sagnikvolt/solar-pv-plant-5mwp-wb/linkedin/README.md

# LinkedIn and CV text (drafts)

Edit into your own voice. Post only after the repo is public (about 30 Nov). Do not claim anything marked "to verify".

## 1. Projects entry

**Title:** 5 MWp Ground-Mount Solar PV Plant: Design and Energy Yield Assessment (West Bengal)
**Dates:** Oct 2026 to Nov 2026
**Associated with:** IEM Kolkata
**Skills to tag:** PVsyst, Solar PV system design, Energy yield assessment, Python, NREL SAM, Cable sizing (add AutoCAD only if you do further work in it)

**Description:**
Designed a 5 MWp fixed-tilt, bifacial ground-mount solar plant using Kolkata's climate data, the way an EPC design team would prepare a preliminary package.
- Selected 565 Wp N-type TOPCon bifacial modules and 250 kW string inverters; sized strings against record temperatures (26 modules per string, 340 strings, DC/AC 1.25) with a Python tool and Excel version.
- Simulated in PVsyst with a 3D shading scene and a row-pitch sweep (6.4 to 9.0 m): 7,078 MWh/yr, 1,417 kWh/kWp, PR 85.6%; P90 6,458 MWh/yr from an assumed uncertainty budget.
- Cross-checked against NREL SAM and PVGIS; the 4.6% gap came from the irradiance database, and fell to 0.9% after scaling to the same irradiance.
- Sized DC and AC cables, transformers and the 33 kV connection concept; produced a plant layout and single-line diagram (generated in Python, saved as DWG in AutoCAD); estimated about 5,000 t CO2 avoided per year.
- Everything is documented with an assumption log. Preliminary design: no site survey, indicative costs.

**Link:** github.com/sagnikvolt/solar-pv-plant-5mwp-wb (add once public)

## 2. Post draft

> I spent the last few weeks designing a 5 MWp solar plant from scratch, to learn what an EPC design team actually does.
>
> The setup: 8,840 bifacial modules, 16 string inverters, Kolkata's climate, fixed tilt 20°.
>
> Three things I learned:
> 1. Row spacing is a trade-off, not a number. Going from 6.4 m to 9.0 m pitch added about 2.6% energy but needed 39% more land. I picked 8.0 m.
> 2. Different weather databases disagree. Kolkata's yearly irradiation is 1,574 (Meteonorm), 1,669 (NASA POWER) or 1,730 (PVGIS) kWh/m². PVsyst came out 4.6% below my SAM check until I scaled SAM to the same irradiance; then they were within 1%. The model was fine; the data source wasn't.
> 3. String sizing is set by the coldest morning. At 3.4 °C, 27 modules of my first module choice reached 1,497 V, just 3 V under the 1,500 V limit. With the final module 27 would still be only 20 V under, so I used 26 for a 5% margin.
>
> Result: 7,078 MWh/yr, PR 85.6%, P90 6,458 MWh/yr (assuming a 6.8% uncertainty). Layout and single-line diagram are in the repo (schematic for now).
>
> Everything, including every assumption and where I'm unsure, is in the repo: [link]
>
> I'm looking for graduate engineer roles in solar (design, projects or O&M) in West Bengal. Feedback from anyone who does this for real is very welcome.
>
> #solar #pvsyst #renewableenergy #westbengal

Numbers behind the post: pitch sweep `calcs/output/pitch_sweep.md` (energy 6,938 to 7,121 MWh = +2.6%; footprint 3.20 to 4.45 ha = +39%). Image to attach: `showcase/images/row_pitch_tradeoff.png` or the loss diagram.

## 3. CV bullets

- Designed and simulated a 5 MWp bifacial solar plant (8,840 modules, 16 string inverters) in PVsyst with 3D shading; achieved 7,078 MWh/yr at PR 85.6% and cross-checked against NREL SAM and PVGIS (gap explained to +0.9%).
- Sized strings, DC/AC cables, transformers and 33 kV evacuation to IEC practice, built a Python/Excel string-sizing tool, produced a schematic layout and single-line diagram, and documented every assumption in a public GitHub repository.

## 4. Things to verify before posting
- Module ALMM/DCR status (MNRE site).
- Capex and LCOE are left out of the post on purpose: they are indicative ranges, not quotes.
- The repo is private until about 30 Nov; add the link only when public.
