sagnikvolt/solar-pv-plant-5mwp-wb/ASSUMPTIONS.md

# Assumptions Log

Every design input that isn't a direct measurement goes here. Each row needs a **source** and a **reason**. When a value changes, update it and note the change in the last column.

| # | Area | Assumption | Value | Source | Reason / note | Changed? |
|---|---|---|---|---|---|---|
| 1 | Plant | DC capacity | 5.0 MWp (design: 4,994.6 kWp) | Project scope | Typical single-feeder 33 kV ground-mount size; actual capacity is set by whole strings | |
| 2 | Plant | Target DC/AC ratio | 1.25 (actual 1.249) | Industry practice | Balance clipping vs. inverter cost; to be tested in PVsyst | |
| 3 | Site | Location | Kolkata, 22.57 °N, 88.36 °E, 15 m | Project choice | Resource site; exact plot TBD (see `data/site.md`) | 28 Oct: changed from Bankura to Kolkata |
| 4 | Site | Record minimum ambient | 3.4 °C | NASA POWER daily T2M_MIN, 2001–2025 | Sets maximum string Voc. Gridded value; a station may read slightly lower | |
| 5 | Site | Design maximum ambient | 47 °C | NASA POWER daily T2M_MAX (46.9 °C) rounded up | Sets minimum string Vmp (MPPT window) | |
| 6 | Irradiance | Annual GHI | Meteonorm 8.1 (1991–2012): **1,573.6**; NASA POWER: 1,669 (+6.1%); PVGIS-ERA5 (2005–2020): 1,730 (+10.0%) kWh/m² | PVsyst Meteonorm import; NASA POWER; PVGIS v5.3 | Spread far above the 3% threshold. Meteonorm is the lowest and the most conservative; it is the basis of the PVsyst simulation. Causes to investigate for the report: different averaging periods, satellite vs. interpolated ground data, and aerosol treatment. Year-to-year GHI variability (Meteonorm): 3.2% | |
| 7 | Module | Model and class | Waaree ELITE BiN-08-565 (565 W) | Waaree datasheet WEL/E&PD/565-600/144/BiN-08/HC/09/03.01.2025 (see `data/datasheets/SOURCES.md`) | N-type TOPCon, bifacial, 144 half-cut cells. **ALMM List-I and DCR status not yet verified** | 28 Oct: 580 W class rejected, see #14 |
| 8 | Module | STC values | Voc 51.9 V, Vmp 43.56 V, Isc 13.75 A, Imp 12.97 A | Same datasheet | | |
| 9 | Module | Temperature coefficients | β(Voc) −0.26 %/°C, α(Isc) +0.046 %/°C, γ(Pmax) −0.30 %/°C; NOCT 43 °C | Same datasheet | The datasheet gives no β(Vmp) | |
| 10 | Inverter | Model | Sungrow SG250HX | Sungrow datasheet v1.22 (© 2019; see SOURCES.md) | 1500 V string inverter, 12 MPPTs, 250 kVA at 30 °C. **Derates to 225 kVA at 40 °C and 200 kVA at 50 °C**: PVsyst must model this for Kolkata summers | |
| 11 | Inverter | Limits used | Vdc max 1500 V; MPPT 600–1500 V; 2 string inputs per MPPT; 26 A operating and 50 A Isc per MPPT | Same datasheet | Newer datasheet revisions may state a lower MPPT minimum voltage; 600 V is conservative | |
| 12 | Design | Cell temperature model | Tcell = Tamb + (NOCT − 20)/800 × 1000 | IEC 61215 NOCT convention | Used for hot-condition Vmp and Isc (75.8 °C) | |
| 13 | Design | Vmp temperature coefficient | γ(Pmax) = −0.30 %/°C used as β(Vmp) | Common approximation | PVsyst's model derives −0.33 %/°C, so −0.30 slightly overstates hot Vmp. No effect on the design: the minimum string is 17 modules and 26 are used | |
| 14 | Design | String length | 26 modules (maximum allowed is 27) | `calcs/output/` | At 27 with the final 565 W module, string Voc reaches 1,480 V (20 V below the limit), so one module was dropped for a 5% margin (1,425 V). The first-pass 580 W module reached 1,497 V at 27. See `iteration1_580W_27mod_FAILED.md` | Iteration 2 |
| 15 | Design | Module class | 565 W instead of 580 W | `calcs/output/` | With the 580 W class, two strings on one MPPT draw 26.36 A, above the inverter's 26 A limit. The 565 W class gives 25.94 A | Iteration 2 |
| 16 | Design | Bifacial rear gain (current only) | 10% | Engineering assumption | Conservative input for current checks only; PVsyst computes the real gain | |
| 17 | Site | Ground albedo (bifacial) | 0.25 | Engineering assumption (grass or bare soil, range 0.2 to 0.3) | PVsyst default is 0.30. Set lower to be conservative. The site file itself carries 0.20 for the front-side model | 28 Oct: set |
| 18 | Losses | Soiling | 3.0% flat annual | Common Indian utility assumption; no site measurement | Monsoon rain cleans in Jun to Sep and winter is dusty, so monthly values would be better. To refine | 28 Oct: set |
| 19 | PVsyst | Weather file | Kolkata_MN81_SYN.MET (Meteonorm 8.1, synthetic hourly) | PVsyst, 28 Oct 2026 | Coordinates picked from PVsyst's map: 22.563 °N, 88.363 °E, 11 m, UTC+5.5 | |
| 20 | PVsyst | Orientation | Fixed tilt 20°, azimuth 0° (south) | PVsyst quick optimisation | Transposition factor 1.06; 0.1% below the optimum (30° would be 0.6% below). Lower tilt also shortens row pitch | |
| 21 | PVsyst | Module file | Waaree_Energies_BiN-08-565.PAN, created by hand from the datasheet | Datasheet values (see #7–9) | Not in PVsyst's Waaree list (older WSMD models only). Created from the WSMD-545 template; Pmax temp. coefficient set to −0.30 %/°C and bifaciality 0.80. PVsyst's one-diode model derives Voc −0.25 %/°C and Vmp −0.33 %/°C (my hand calc used −0.30 for Vmp, so PVsyst is slightly more conservative on Vmp). Rsh/Rs are PVsyst defaults, not from the datasheet | |
| 22 | PVsyst | Inverter | Sungrow SG250-HX from PVsyst's database | PVsyst database (since 2022) | The database entry lists the MPPT range as 500–1450 V; datasheet v1.22 says 600–1500 V. Both are satisfied by the 26-module string (Vmp 960–1206 V) | |
| 23 | PVsyst | Array | 26 modules in series, 340 strings, 16 inverters (192 MPPT inputs) | `calcs/string_sizing.py` | PVsyst confirms 8,840 modules, 4,995 kWp, 4,000 kWac, ratio 1.249, Voc at −10 °C 1,465 V. 44 MPPT inputs get 1 string and 148 get 2 | |
| 24 | PVsyst | Row pitch | **8.0 m** (GCR 58%) | `calcs/row_pitch.py`, `calcs/pitch_sweep.py` | 6.4 m is the minimum for no shading 9:00 to 15:00 on 21 Dec at Kolkata. PVsyst sweep: 6.4 m 6,938; 7.0 m 7,006; 8.0 m 7,078; 9.0 m 7,121 MWh. Gains flatten above 8 m while land keeps growing. May change with the real plot and land cost | 28 Oct: 7.0 to 8.0 m |
| 25 | PVsyst | Table geometry | 2 modules portrait, 4.58 m deep, 20° tilt, 1.0 m lower-edge height, 17 rows of 260 modules in length (300 m) | Engineering assumption | 1.0 m clearance for flood-prone West Bengal. Row length is a placeholder until the real plot is chosen | 28 Oct |
| 26 | PVsyst | Bifacial model | Unlimited sheds 2D; bifaciality 80%; rear shading 5%; rear mismatch 10% | PVsyst defaults and module file | PVsyst gives 6.5% rear irradiance relative to front. Estimated net energy gain about 4.7% (6.5% × 0.80 × 0.90, my arithmetic, not a PVsyst output) | 28 Oct |
| 27 | PVsyst | Near shading | Linear shadings (fast table) from the 3D scene, 2.26% loss at 7.0 m pitch (VC1); 1.75% at the adopted 8.0 m (VC4) | PVsyst | Conservative vs electrical (module-string) shading. Module-layout partition not defined yet | 28 Oct |
| 28 | PVsyst | Thermal model | Free-standing: Uc 29 W/m²K, Uv 0 | PVsyst convention for free-mounted | Cuts temperature loss from 7.8% (Uc 20) to 5.6%, a gain of about 2%. Worth cross-checking against SAM | 28 Oct |
| 29 | PVsyst | Other losses | LID 0.5%; module quality 0.0% (PVsyst default assumes a 0.5% gain, removed); mismatch 2.0%; DC ohmic 1.5% at STC (to confirm by cable sizing); unavailability 1.0%; AC wiring and auxiliaries not modelled | Engineering assumptions | Availability is placed in 3 random periods totalling 3.7 days, which distorts the monthly chart (June PR 0.776). Annual total unaffected | 28 Oct |
| 30 | Uncertainty | P50/P90 budget | σ(1 yr) 6.84%: data source 5.0, interannual 3.2, transposition 2.0, PV model 2.0, module 1.5, soiling 1.0, availability 0.5 | `calcs/p50_p90.py` | All components are assumptions. On the VC4 P50 of 7,078 MWh: P90 (1 yr) 6,458 MWh | 28 Oct |
| 31 | Check | Bifacial gain | +4.4% (monofacial VC2 6,712 vs bifacial VC1 7,006 MWh, both at 7.0 m) | PVsyst runs | Replaces my earlier 4.7% estimate | 28 Oct |
| 32 | Check | SAM / PVGIS cross-check | PVsyst monofacial sits 4.6% and 6.6% below SAM and PVGIS (ERA5) after removing shading; within 0.9% after scaling SAM to Meteonorm GHI | `calcs/crosscheck_sam_pvgis.md` | Difference is irradiance database, not model. SAM and PVGIS share ERA5, so this does not validate the irradiance choice | 28 Oct |
| 33 | Cables | DC string cable | Copper H1Z2Z2-K 1.5 kV; design current 1.25 x Isc x 1.10 = 18.9 A; temperature derating 0.91 (70 C ambient, 120 C cable); grouping 0.80; voltage drop limit 1.0% at Imp | IEC 62548-style practice; `calcs/cable_sizing.py` | Result: 4 mm2 to about 70 m, 6 mm2 to 100 m, 10 mm2 to 130 m. Row lengths and combiner positions are not drawn yet, so cable lengths are placeholders | 28 Oct |
| 34 | Cables | Inverter to transformer cable | Aluminium XLPE, 80 m, 240 mm2, 3 single-core per inverter; buried derating 0.80; drop at most 0.5% at rated 180.5 A | `calcs/cable_sizing.py` | 185 mm2 gives 0.62%, so 240 mm2 chosen. Ampacities are typical datasheet values, not verified against a specific vendor | 28 Oct |
| 35 | Electrical | Transformers | 2 x 2.5 MVA, 0.8/33 kV Dyn11 ONAN; 8 inverters each; no-load 2.1 kW, load loss 20 kW | Engineering assumption, typical values | Check against vendor data. Inverters derate to 225 kVA at 40 C, so 2.5 MVA is not overloaded | 28 Oct |
| 36 | Electrical | 33 kV evacuation | 70 A at 4.0 MW; 3 km ACSR Dog overhead line (R 0.27 ohm/km); drop 0.30%, loss 11.9 kW | Placeholder | Line length and grid substation are unknown until the plot and DISCOM feasibility are fixed | 28 Oct |
| 37 | Losses | AC-side energy loss | 161.3 MWh/yr (2.28% of 7,078); load-form factor mean(P^2)/Prated^2 = 0.20 | `calcs/cable_sizing.py` | The 0.20 factor is an assumption; replace with PVsyst hourly output. Net 6,917 MWh/yr at the 33 kV point | 28 Oct |
| 38 | Economics | Capex | Cost lines positioned at the 25th percentile of published indicative ranges: INR 4.42 crore/MWp (22.1 crore); low case 3.54, high 7.08 per MWp | taypro.in cost guide (updated 21 Jun 2026); `calcs/economics.py` | Commercial blog, not a regulator figure. Even the low case gives LCOE above auction tariffs, so quote only as a range until a CERC/SERC benchmark or EPC quote is found | 28 Oct |
| 39 | Economics | Financial inputs | Discount rate 10% nominal pre-tax; O&M INR 5 lakh/MWp/yr escalating 4%; insurance 0.3% of EPC; inverter replacement INR 0.48 crore in year 12; degradation 0.4%/yr; 25 years; no tax, debt or subsidy | Engineering/finance assumptions | None is sourced to a project; they are typical placeholders | 28 Oct |
| 40 | Economics | Tariff scenarios | INR 2.34 (GUVNL auction, Mar 2026), 3.00 (base, my assumption), 3.62 (DVC West Bengal interim, Mar 2025) | News headlines | Headlines only, full orders not opened | 28 Oct |
| 41 | Environment | Grid emission factor | 0.727 tCO2/MWh (weighted average), 0.757 (combined margin) | CEA CO2 Baseline Database v20.0, FY 2023-24 | About 5,030 to 5,240 t/yr avoided in year 1. A falling grid factor makes later years lower | 28 Oct |
| 42 | Drawings | Layout geometry | 17 rows x 10 tables (30.0 m each); 4.30 m plan depth per table; 4 m internal road 6 m outside the array; fence 12 m beyond the array; inverters shown at the east end of rows 1 to 16; yard 56 m x 116 m east of the array; fence area about 6.2 ha (15 acres) | Engineering assumption, `calcs/make_drawings.py` | Schematic. Symbols are enlarged, yard position and 33 kV route are placeholders, and the real plot may need a different shape. The 3.97 ha figure elsewhere is the array footprint only | 28 Oct |
