sagnikvolt/solar-pv-plant-5mwp-wb/calcs/output/weather_comparison.md

# Irradiance cross-check

| Source | Annual GHI (kWh/m²/yr) | Δ vs Meteonorm |
|---|---|---|
| Meteonorm | 1,574 | +0.0% |
| PVGIS | 1,730 | +10.0% |
| NASA POWER | 1,669 | +6.1% |

_Explain any difference above ~3% in the report (data period, satellite vs. ground-station interpolation, spatial resolution)._
