sagnikvolt/solar-pv-plant-5mwp-wb/showcase/pvsyst_report_VC4_pitch8m_PRELIMINARY.pdf

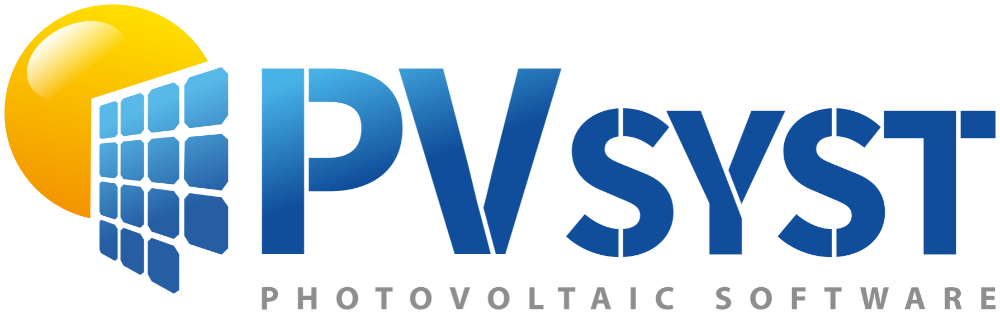
[picture p20: figure]

## Version 7.4.7

# PVsyst - Simulation report

# Grid-Connected System

# Project: SPV5_Kolkata_5MWp

## Variant: Bifacial 20deg, PITCH 8.0m, 3D sheds, soiling 3pct Sheds, single array System power: 4995 kWp Kolkata - India

Author

PVsyst V7.4.7
VC4, Simulation date:
28/10/26 13:35
with V7.4.7

## Project: SPV5_Kolkata_5MWp

### Variant: Bifacial 20deg, PITCH 8.0m, 3D sheds, soiling 3pct

PVsyst Licensed to

### Project summary

Geographical Site
Kolkata
India

Situation
Latitude
Longitude
Altitude
Time zone

22.56
88.36
11
UTC+5.5

°N
°E
m

Project settings
Albedo | 0.20

Weather data
Kolkata
Meteonorm 8.1 (1991-2012) - Synthetic

### System summary

Grid-Connected System | Sheds, single array

PV Field Orientation
Fixed plane
Tilt/Azimuth | 20 / 0 °

Near Shadings
Linear shadings : Fast (table)

User's needs
Unlimited load (grid)

System information
PV Array
Nb. of modules
Pnom total

8840
4995

units
kWp

Inverters
Nb. of units
Pnom total
Pnom ratio

16
3999
1.249

units
kWac

### Results summary

Produced Energy | 7078053 kWh/year | Specific production | 1417 kWh/kWp/year Perf. Ratio PR | 85.65 %

### Table of contents

Project and results summary
General parameters, PV Array Characteristics, System losses Near shading definition - Iso-shadings diagram
Main results
Loss diagram
Predef. graphs

2
3
5
6
7
8

PVsyst V7.4.7
VC4, Simulation date:
28/10/26 13:35
with V7.4.7

### General parameters

Grid-Connected System | Sheds, single array

PV Field Orientation
Orientation
Fixed plane
Tilt/Azimuth | 20 / 0 °

Sheds configuration
Nb. of sheds
Single array

17 units

Sizes
Sheds spacing
Collector width
Ground Cov. Ratio (GCR)
Top inactive band
Bottom inactive band

8.00
4.58
57.2
0.02
0.02

m
m
%
m
m
Shading limit angle
Limit profile angle | 23.1 °

Models used
Transposition
Diffuse
Circumsolar

Perez
Perez, Meteonorm
separate

Horizon
Free Horizon

Near Shadings
Linear shadings : Fast (table)

User's needs
Unlimited load (grid)

Bifacial system
Model | 2D Calculation
| unlimited sheds
Bifacial model geometry
Sheds spacing Sheds width Limit profile angle GCR Height above ground | 8.00
| 4.62
| 23.1
| 57.7
| 1.00 m
| m
| °
| %
| m

Bifacial model definitions Ground albedo
Bifaciality factor
Rear shading factor
Rear mismatch loss
Shed transparent fraction

0.25
80
5.0
10.0
0.0

%
%
%
%

### PV Array Characteristics

PV module
Manufacturer Model | Waaree Energies
| BiN-08-565
(Custom parameters definition)
Unit Nom. Power | 565 Wp
Number of PV modules Nominal (STC) Modules | 8840
| 4995
| 340 string x 26 units
| kWp
| In series
At operating cond. (50°C)
Pmpp U mpp I mpp | 4620
| 1034
| 4467 kWp
| V
| A

Inverter
Manufacturer
Model

Sungrow
SG250-HX
(Original PVsyst database)
Unit Nom. Power | 250 kWac
Number of inverters Total power | 192 * MPPT 8% 16
| 3999 units
| kWac
Operating voltage Pnom ratio (DC:AC) No power sharing between MPPTs | 500-1450
| 1.25 V

Total PV power
Nominal (STC)
Total
Module area

4995
8840
22836

kWp
modules
m²

Total inverter power
Total power
Number of inverters
Pnom ratio

3999
16
1.25

kWac
units

PVsyst V7.4.7

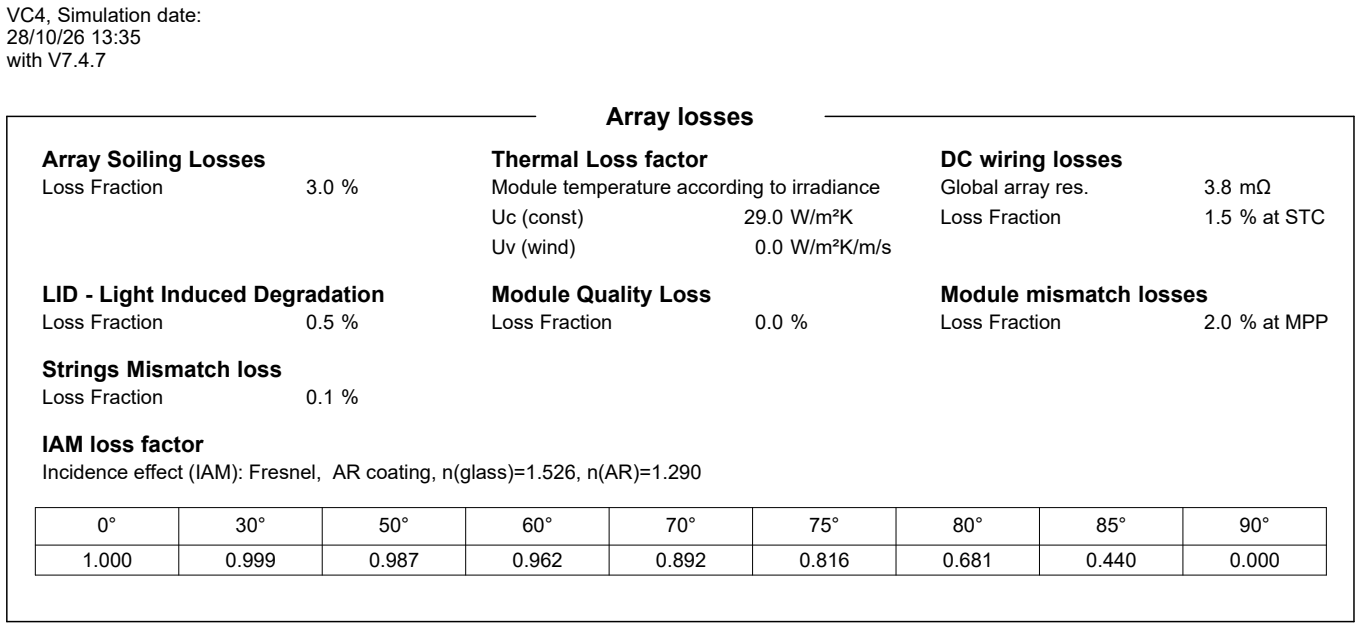
[picture p21: figure]
VC4, Simulation date: 28/10/26 13:35 with V7.4.7; Array losses; Array Soiling Losses; Loss Fraction; Thermal Loss factor; Module temperature according to irradiance; Uc (const); Uv (wind); W/m²K; W/m²K/m/s; DC wiring losses; Global array res.; % at STC; LID - Light Induced Degradation; Module Quality Loss; Module mismatch losses; 2.0 % at MPP; Strings Mismatch loss; IAM loss factor

Incidence effect (IAM): Fresnel, AR coating, n(glass)=1.526, n(AR)=1.290

### System losses

Unavailability of the system
Time fraction | 1.0
| 3.7
| 3

%
days,
periods

### Near shadings parameter

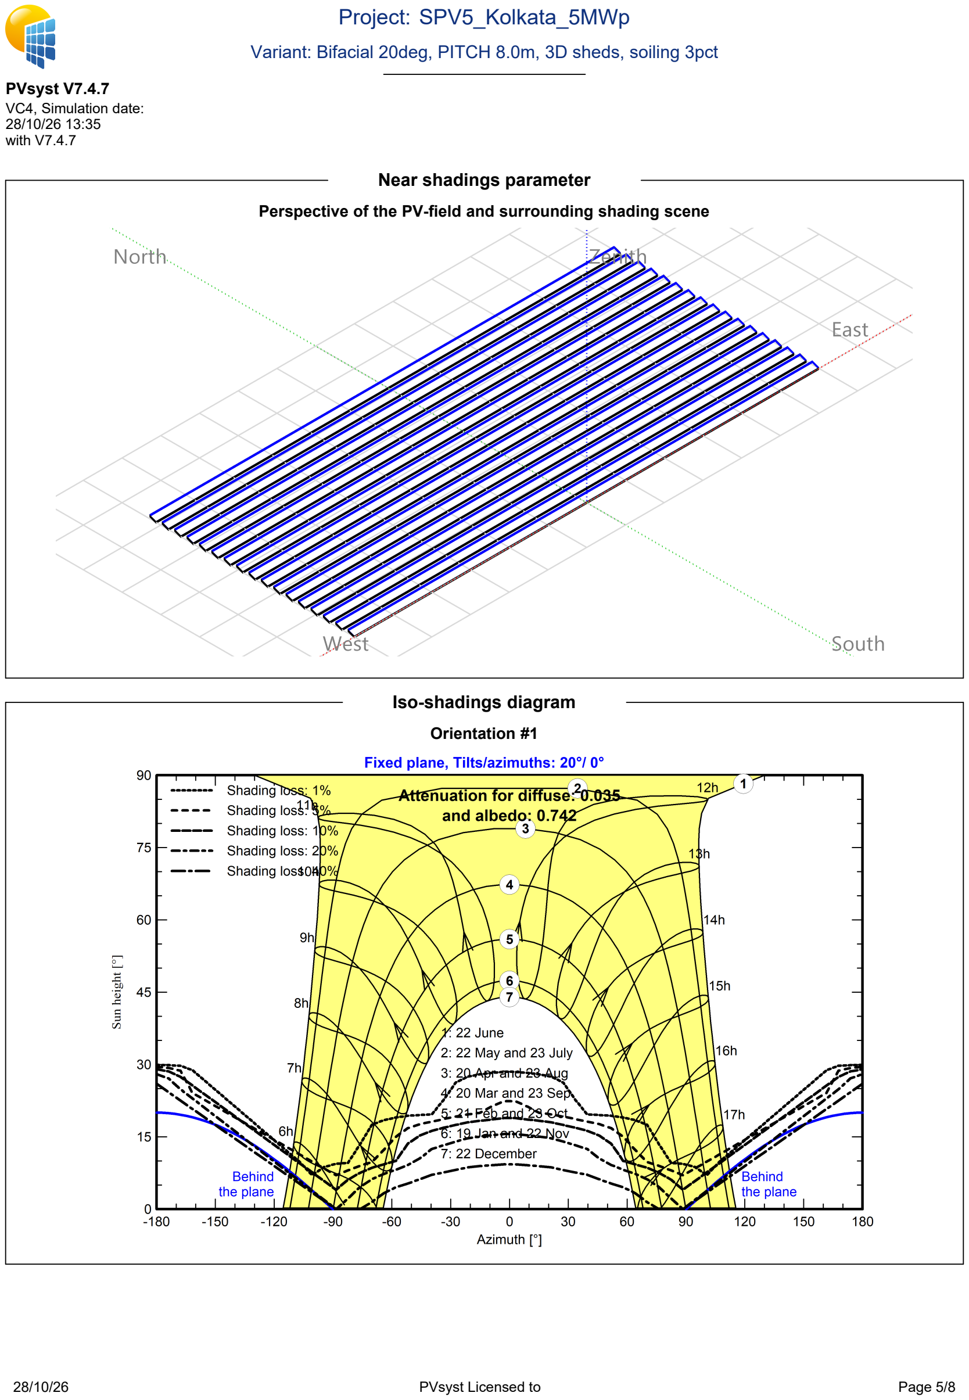
[picture p22: page 5]

PVsyst V7.4.7
VC4, Simulation date:
28/10/26 13:35
with V7.4.7

Perspective of the PV-field and surrounding shading scene

### Iso-shadings diagram

Orientation #1

PVsyst V7.4.7
VC4, Simulation date:
28/10/26 13:35
with V7.4.7

### Main results

System Production
Produced Energy | 7078053 kWh/year | Specific production
| | Perf. Ratio PR

1417
85.65

kWh/kWp/year
%
Normalized productions (per installed kWp) | Performance Ratio PR

Balances and main results

| GlobHor kWh/m² | DiffHor kWh/m² | T_Amb °C | GlobInc kWh/m² | GlobEff kWh/m² | EArray kWh | E_Grid kWh | PR ratio
January February March April May June July August September October November December | 112.1 118.0 156.9 166.5 171.7 134.0 128.3 125.0 120.4 121.8 112.8 106.1 | 60.55 67.00 85.04 88.89 96.70 93.63 87.28 83.59 78.22 73.59 60.86 57.07 | 17.45 22.10 27.55 30.18 31.43 30.47 29.78 29.36 28.31 27.25 23.36 18.68 | 135.2 133.7 167.3 167.7 163.5 125.5 120.8 122.5 122.8 132.9 133.4 129.3 | 126.7 125.5 157.1 157.4 152.8 116.3 111.9 113.8 114.3 124.3 125.2 121.4 | 611856 593718 723424 720603 706818 555398 532542 534466 534374 581200 591292 583649 | 602898 584978 712927 709930 695431 491910 521809 524042 524913 571700 582257 555258 | 0.893 0.876 0.853 0.847 0.852 0.785 0.865 0.857 0.856 0.861 0.874 0.860
Year | 1573.6 | 932.42 | 26.34 | 1654.6 | 1546.9 | 7269341 | 7078053 | 0.856

Legends
GlobHor
DiffHor
T_Amb
GlobInc
GlobEff

Global horizontal irradiation Horizontal diffuse irradiation
Ambient Temperature
Global incident in coll. plane
Effective Global, corr. for IAM and shadings

EArray
E_Grid
PR

Effective energy at the output of the array Energy injected into grid
Performance Ratio

### Loss diagram

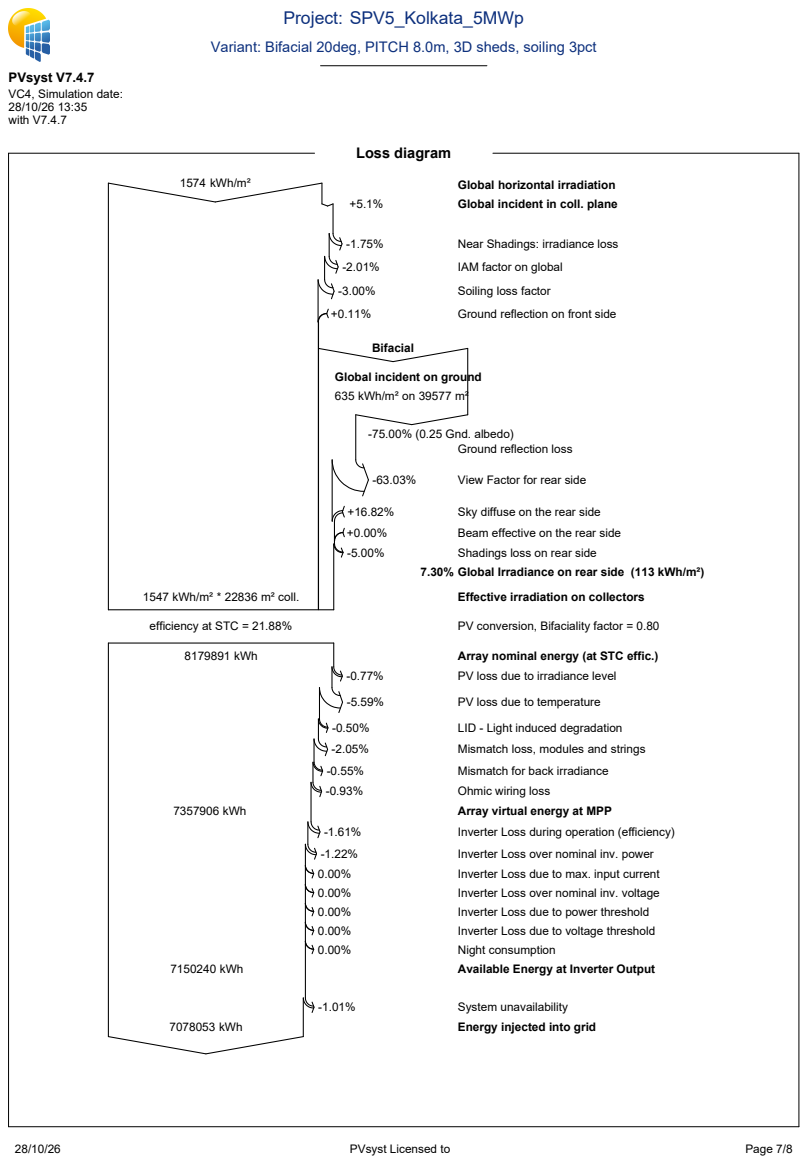
[picture p23: page 7]
PVsyst V7.4.7; VC4, Simulation date: 28/10/26 13:35 with V7.4.7; 1574 kWh/m²; Global horizontal irradiation; Global incident in coll. plane; Near Shadings: irradiance loss; IAM factor on global; Soiling loss factor; Ground reflection on front side; Bifacial; -75.00% (0.25 Gnd. albedo); View Factor for rear side; Sky diffuse on the rear side; Beam effective on the rear side; Shadings loss on rear side; 1547 kWh/m² * 22836 m² coll.; Effective irradiation on collectors; efficiency at STC = 21.88%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

Global incident on ground
635 kWh/m² on 39577 m²

Ground reflection loss

7.30% Global Irradiance on rear side (113 kWh/m²)

### Predef. graphs

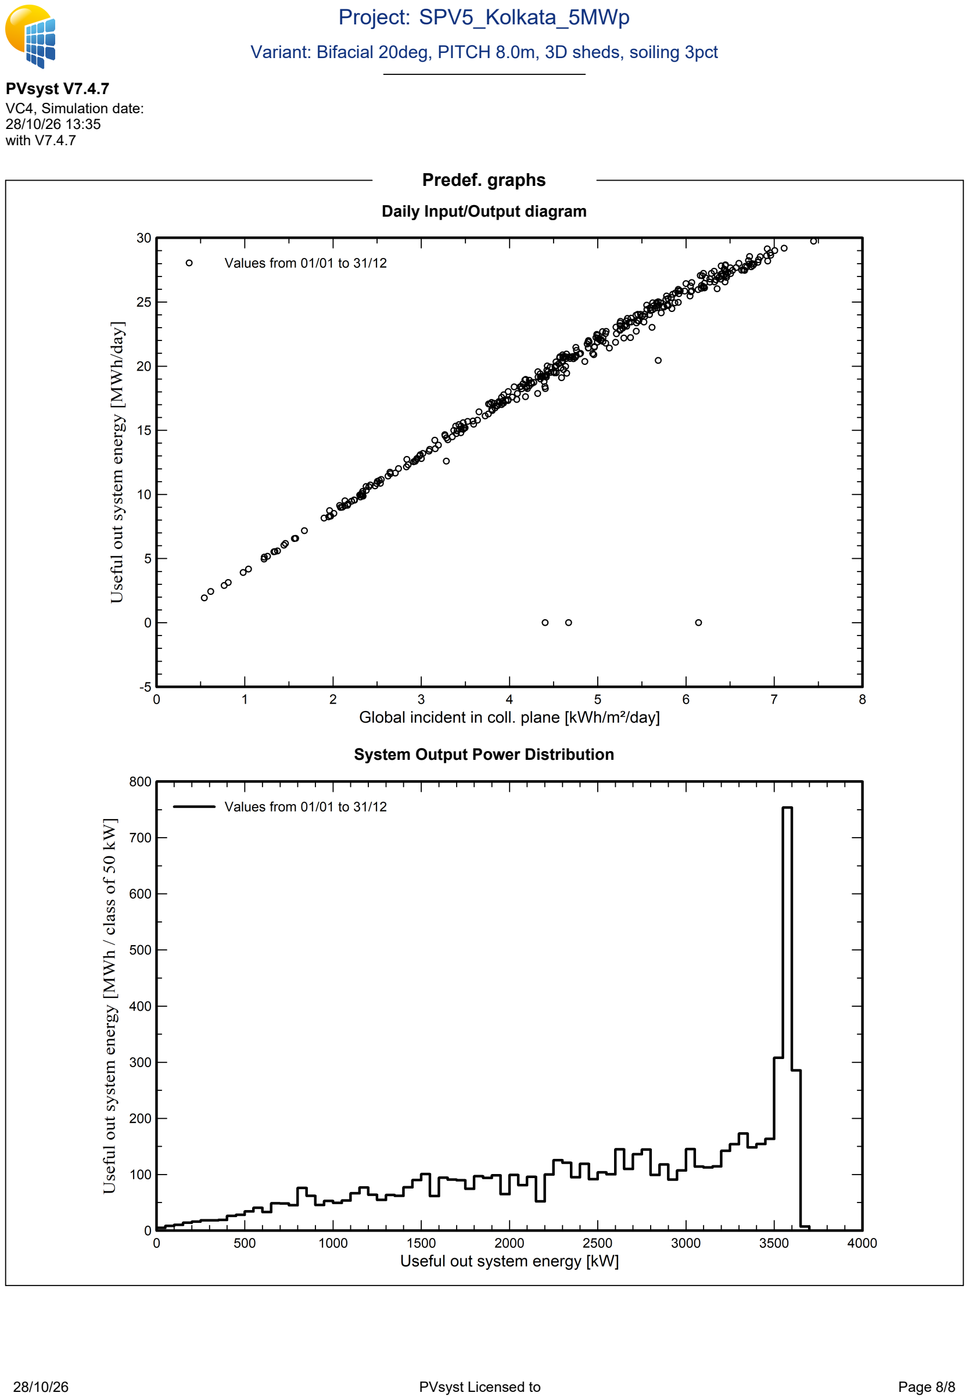
[picture p24: page 8]

PVsyst V7.4.7
VC4, Simulation date:
28/10/26 13:35
with V7.4.7

Daily Input/Output diagram

System Output Power Distribution
