sagnikvolt/solar-pv-plant-5mwp-wb/showcase/pvsyst_report_VC1_bifacial_shaded_PRELIMINARY.pdf

## Version 7.4.7

# PVsyst - Simulation report

# Grid-Connected System

# Project: SPV5_Kolkata_5MWp

## Variant: Bifacial 20deg, pitch 7m, 3D sheds, soiling 3pct, 26x565W x 340, 16x SG250HX Sheds, single array System power: 4995 kWp Kolkata - India

Author

PVsyst V7.4.7
VC1, Simulation date:
28/10/26 13:20
with V7.4.7

## Project: SPV5_Kolkata_5MWp

### Variant: Bifacial 20deg, pitch 7m, 3D sheds, soiling 3pct, 26x565W x 340, 16x SG250HX

PVsyst Licensed to

### Project summary

Geographical Site
Kolkata
India

Situation
Latitude
Longitude
Altitude
Time zone

22.56
88.36
11
UTC+5.5

°N
°E
m

Project settings
Albedo | 0.20

Weather data
Kolkata
Meteonorm 8.1 (1991-2012) - Synthetic

### System summary

Grid-Connected System | Sheds, single array

PV Field Orientation
Fixed plane
Tilt/Azimuth | 20 / 0 °

Near Shadings
Linear shadings : Fast (table)

User's needs
Unlimited load (grid)

System information
PV Array
Nb. of modules
Pnom total

8840
4995

units
kWp

Inverters
Nb. of units
Pnom total
Pnom ratio

16
4000
1.249

units
kWac

### Results summary

Produced Energy | 7006164 kWh/year | Specific production | 1403 kWh/kWp/year Perf. Ratio PR | 84.78 %

### Table of contents

Project and results summary
General parameters, PV Array Characteristics, System losses Near shading definition - Iso-shadings diagram
Main results
Loss diagram
Predef. graphs

2
3
5
6
7
8

PVsyst V7.4.7
VC1, Simulation date:
28/10/26 13:20
with V7.4.7

### General parameters

Grid-Connected System | Sheds, single array

PV Field Orientation
Orientation
Fixed plane
Tilt/Azimuth | 20 / 0 °

Sheds configuration
Nb. of sheds
Single array

17 units

Sizes
Sheds spacing
Collector width
Ground Cov. Ratio (GCR)
Top inactive band
Bottom inactive band

7.00
4.58
65.4
0.02
0.02

m
m
%
m
m
Shading limit angle
Limit profile angle | 30.4 °

Models used
Transposition
Diffuse
Circumsolar

Perez
Perez, Meteonorm
separate

Horizon
Free Horizon

Near Shadings
Linear shadings : Fast (table)

User's needs
Unlimited load (grid)

Bifacial system
Model | 2D Calculation
| unlimited sheds
Bifacial model geometry
Sheds spacing Sheds width Limit profile angle GCR Height above ground | 7.00
| 4.62
| 30.4
| 65.9
| 1.00 m
| m
| °
| %
| m

Bifacial model definitions Ground albedo
Bifaciality factor
Rear shading factor
Rear mismatch loss
Shed transparent fraction

0.25
80
5.0
10.0
0.0

%
%
%
%

### PV Array Characteristics

PV module
Manufacturer Model | Waaree Energies
| BiN-08-565
(Custom parameters definition)
Unit Nom. Power | 565 Wp
Number of PV modules Nominal (STC) Modules | 8840
| 4995
| 340 string x 26 units
| kWp
| In series
At operating cond. (50°C)
Pmpp U mpp I mpp | 4620
| 1034
| 4467 kWp
| V
| A

Inverter
Manufacturer
Model

Sungrow
SG250-HX
(Original PVsyst database)
Unit Nom. Power | 250 kWac
Number of inverters Total power | 192 * MPPT 8% 16
| 4000 units
| kWac
Operating voltage Pnom ratio (DC:AC) No power sharing between MPPTs | 500-1450
| 1.25 V

Total PV power
Nominal (STC)
Total
Module area

4995
8840
22836

kWp
modules
m²

Total inverter power
Total power
Number of inverters
Pnom ratio

4000
16
1.25

kWac
units

PVsyst V7.4.7

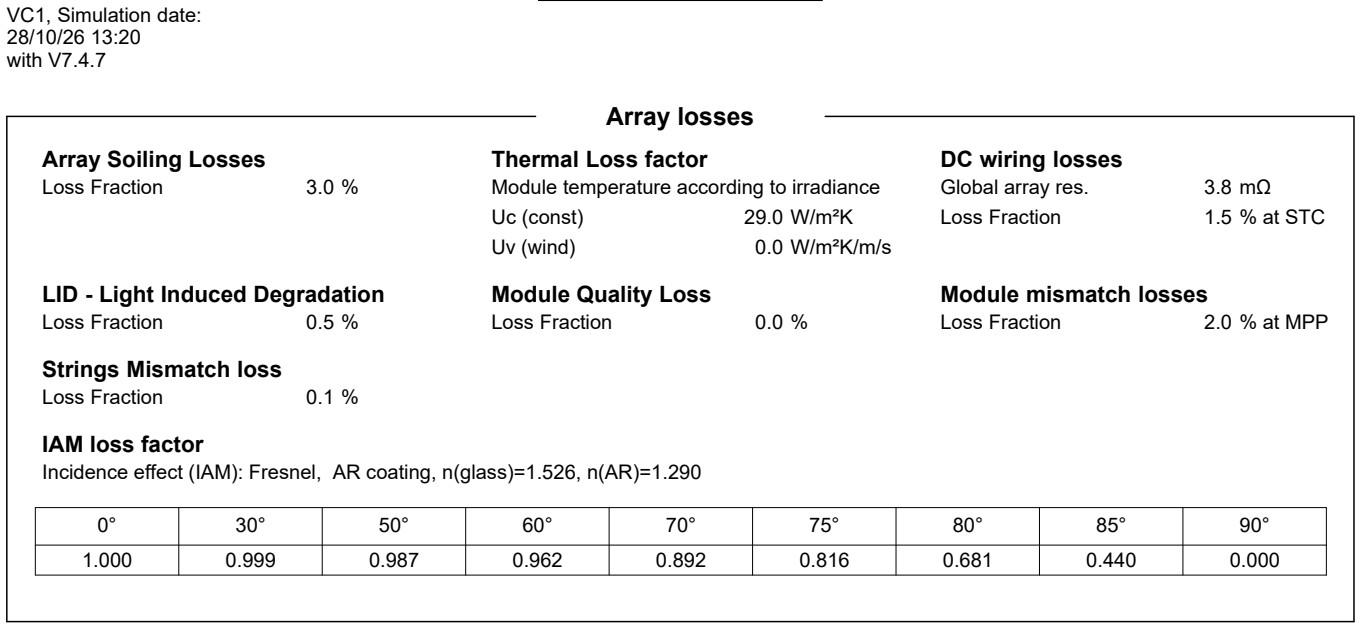
[picture p25: figure]
VC1, Simulation date: 28/10/26 13:20 with V7.4.7; Array losses; Array Soiling Losses; Loss Fraction; Thermal Loss factor; Module temperature according to irradiance; Uc (const); Uv (wind); W/m²K; W/m²K/m/s; DC wiring losses; Global array res.; % at STC; LID - Light Induced Degradation; Module Quality Loss; Module mismatch losses; 2.0 % at MPP; Strings Mismatch loss; IAM loss factor

Incidence effect (IAM): Fresnel, AR coating, n(glass)=1.526, n(AR)=1.290

### System losses

Unavailability of the system
Time fraction | 1.0
| 3.7
| 3

%
days,
periods

### Near shadings parameter

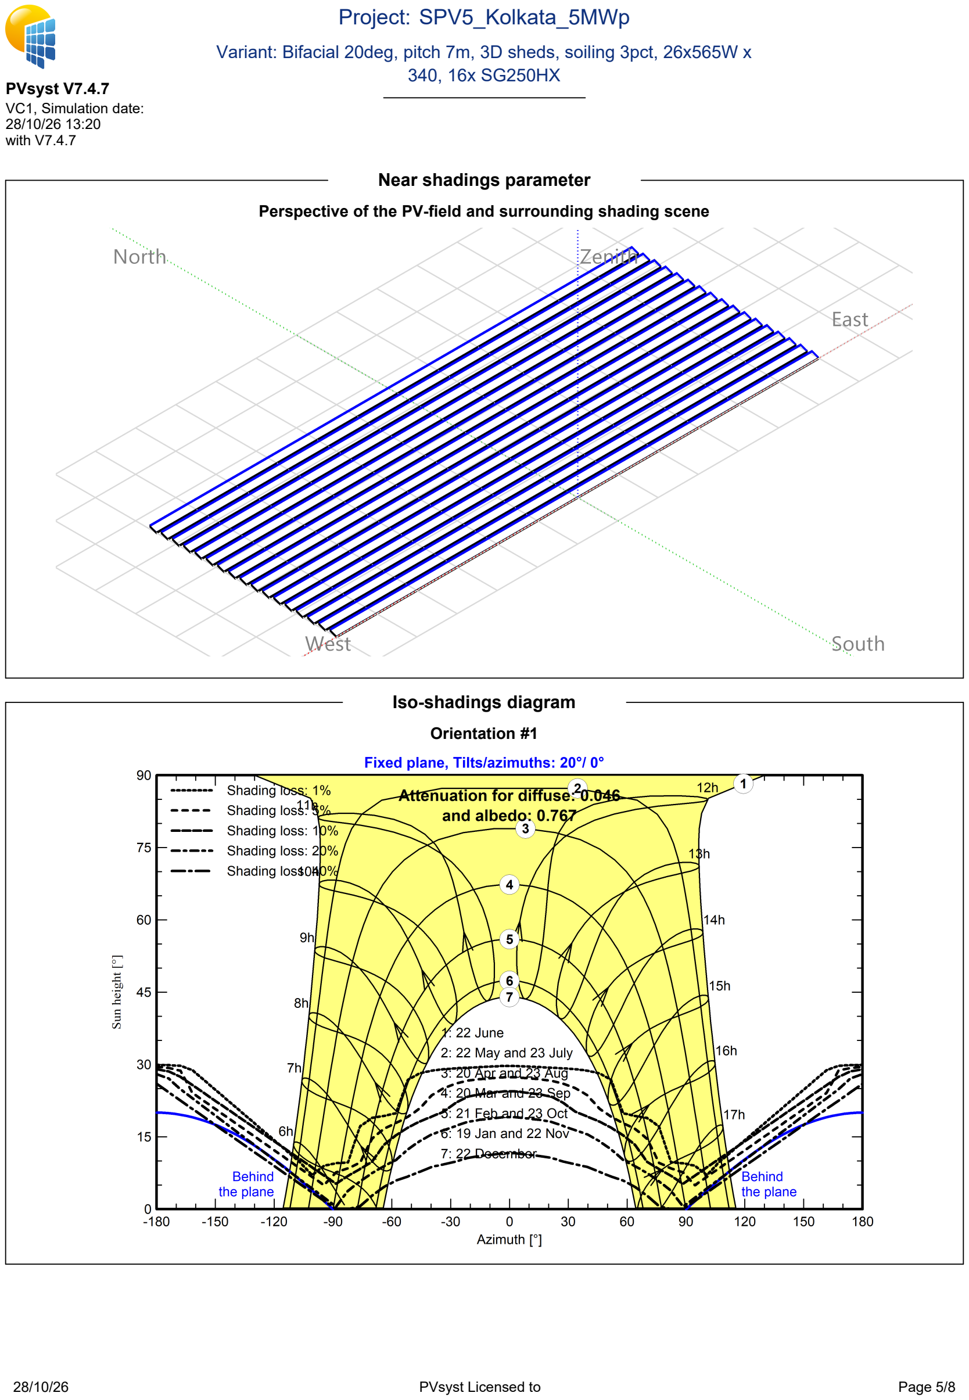
[picture p26: page 5]

PVsyst V7.4.7
VC1, Simulation date:
28/10/26 13:20
with V7.4.7

Perspective of the PV-field and surrounding shading scene

### Iso-shadings diagram

Orientation #1

PVsyst V7.4.7
VC1, Simulation date:
28/10/26 13:20
with V7.4.7

### Main results

System Production
Produced Energy | 7006164 kWh/year | Specific production
| | Perf. Ratio PR

1403
84.78

kWh/kWp/year
%
Normalized productions (per installed kWp) | Performance Ratio PR

Balances and main results

| GlobHor kWh/m² | DiffHor kWh/m² | T_Amb °C | GlobInc kWh/m² | GlobEff kWh/m² | EArray kWh | E_Grid kWh | PR ratio
January February March April May June July August September October November December | 112.1 118.0 156.9 166.5 171.7 134.0 128.3 125.0 120.4 121.8 112.8 106.1 | 60.55 67.00 85.04 88.89 96.70 93.63 87.28 83.58 78.22 73.59 60.86 57.07 | 17.45 22.10 27.55 30.18 31.43 30.47 29.78 29.36 28.31 27.25 23.36 18.68 | 135.2 133.7 167.3 167.7 163.5 125.5 120.8 122.5 122.8 132.9 133.4 129.3 | 125.8 124.9 156.6 156.8 152.2 115.7 111.2 113.2 113.7 123.8 124.5 120.4 | 602780 588327 718680 715662 701253 549382 526927 529310 529585 576196 584473 573883 | 593848 579599 708203 705011 689886 486442 516207 518895 520134 566709 575463 545769 | 0.879 0.868 0.847 0.842 0.845 0.776 0.855 0.848 0.848 0.854 0.864 0.845
Year | 1573.6 | 932.42 | 26.34 | 1654.6 | 1538.8 | 7196457 | 7006164 | 0.848

Legends
GlobHor
DiffHor
T_Amb
GlobInc
GlobEff

Global horizontal irradiation Horizontal diffuse irradiation
Ambient Temperature
Global incident in coll. plane
Effective Global, corr. for IAM and shadings

EArray
E_Grid
PR

Effective energy at the output of the array Energy injected into grid
Performance Ratio

### Loss diagram

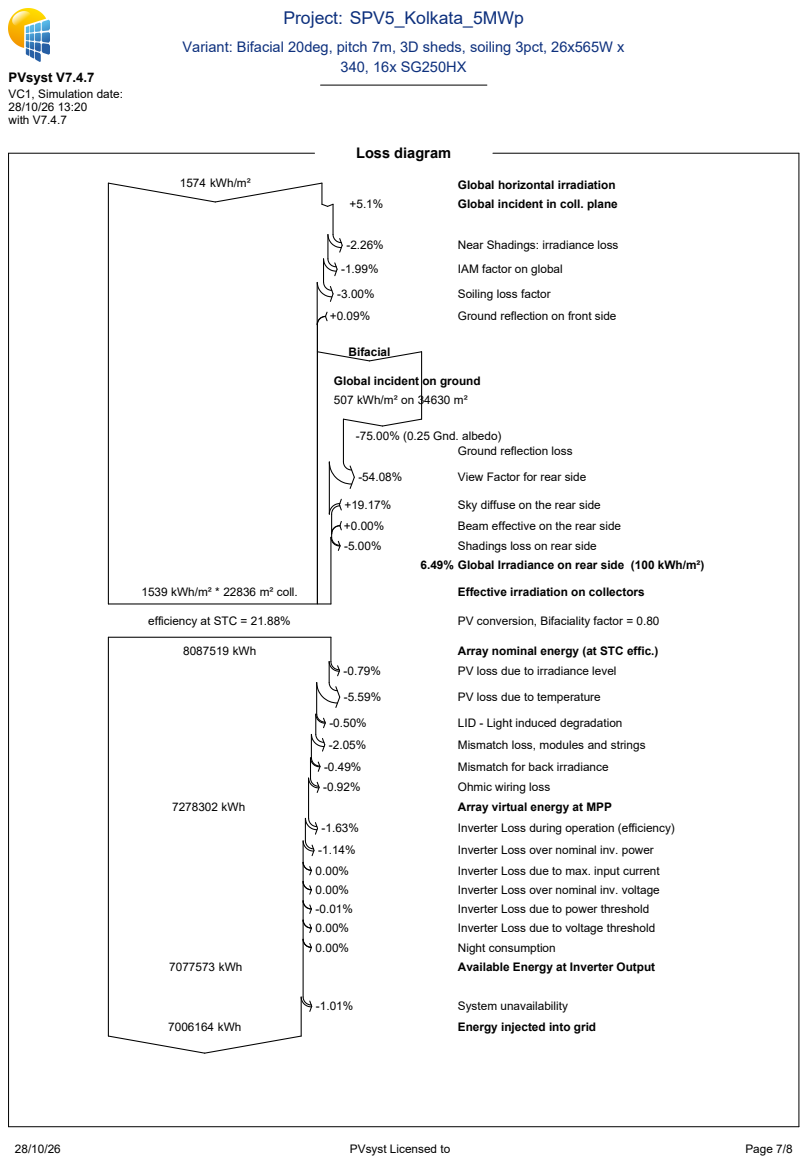
[picture p27: page 7]
PVsyst V7.4.7; VC1, Simulation date: 28/10/26 13:20 with V7.4.7; 1574 kWh/m²; Global horizontal irradiation; Global incident in coll. plane; Near Shadings: irradiance loss; IAM factor on global; Soiling loss factor; Ground reflection on front side; Bifacial; -75.00% (0.25 Gnd. albedo); View Factor for rear side; Sky diffuse on the rear side; Beam effective on the rear side; Shadings loss on rear side; 1539 kWh/m² * 22836 m² coll.; Effective irradiation on collectors; efficiency at STC = 21.88%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

Global incident on ground
507 kWh/m² on 34630 m²

Ground reflection loss

6.49% Global Irradiance on rear side (100 kWh/m²)

### Predef. graphs

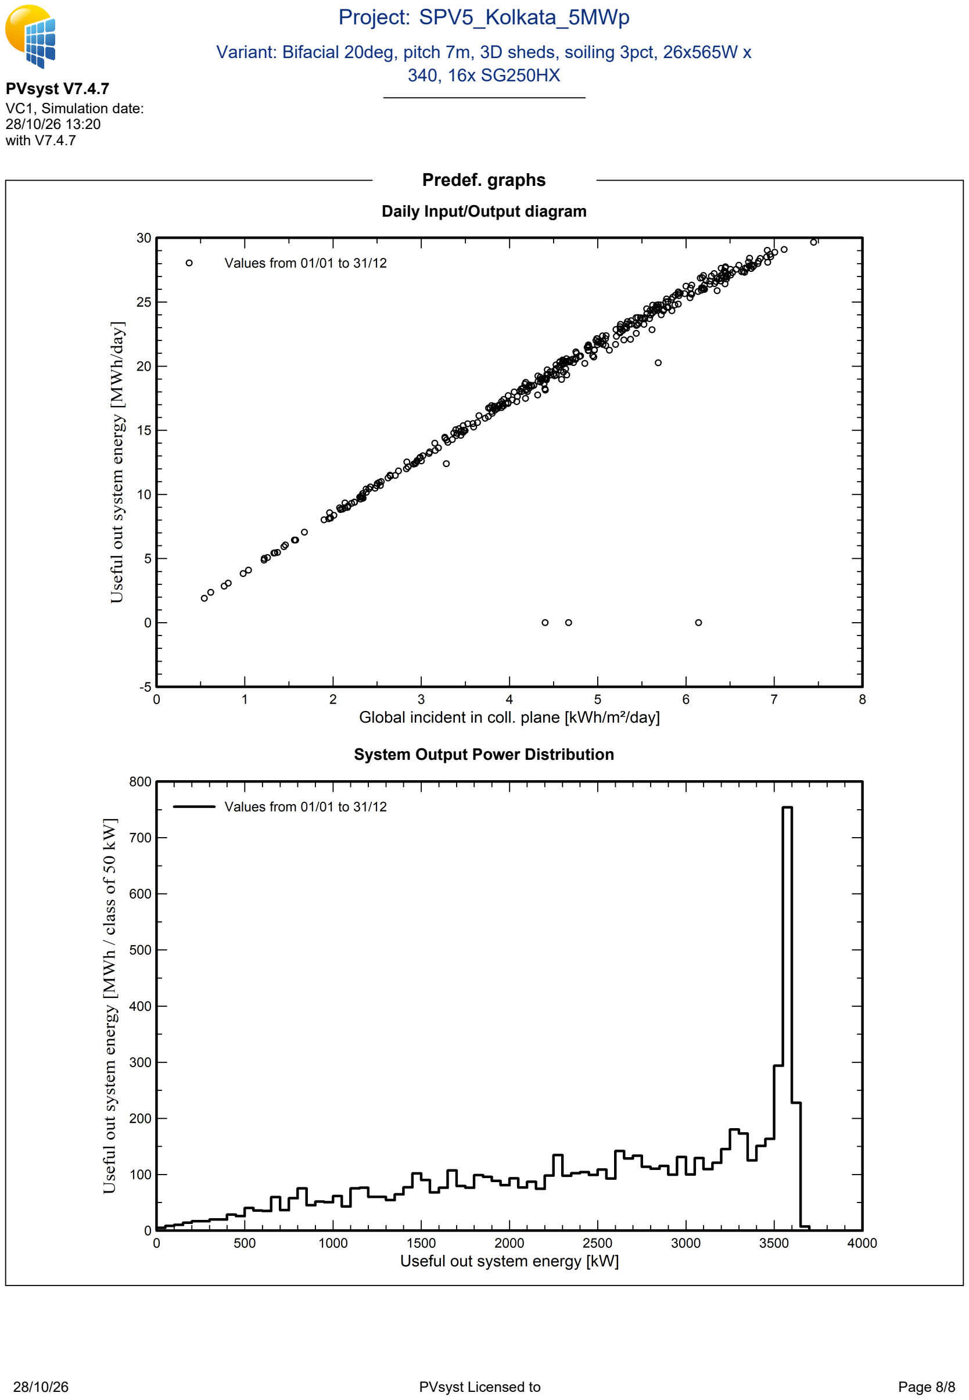
[picture p28: page 8]

PVsyst V7.4.7
VC1, Simulation date:
28/10/26 13:20
with V7.4.7

Daily Input/Output diagram

System Output Power Distribution
