sagnikvolt/solar-pv-plant-5mwp-wb/showcase/pvsyst_report_VC0_baseline_PRELIMINARY.pdf

## Version 7.4.7

# PVsyst - Simulation report

# Grid-Connected System

# Project: SPV5_Kolkata_5MWp

## Variant: Base case: 20deg tilt, no shading, 26x565W x 340 strings, 16x SG250HX No 3D scene defined, no shadings System power: 4995 kWp Kolkata - India

Author

PVsyst V7.4.7
VC0, Simulation date:
28/10/26 12:20
with V7.4.7

## Project: SPV5_Kolkata_5MWp

### Variant: Base case: 20deg tilt, no shading, 26x565W x 340 strings, 16x SG250HX

PVsyst Licensed to

### Project summary

Geographical Site
Kolkata
India

Situation
Latitude
Longitude
Altitude
Time zone

22.56
88.36
11
UTC+5.5

°N
°E
m

Project settings
Albedo | 0.20

Weather data
Kolkata
Meteonorm 8.1 (1991-2012) - Synthetic

### System summary

Grid-Connected System | No 3D scene defined, no shadings

PV Field Orientation
Fixed plane
Tilt/Azimuth | 20 / 0 °

Near Shadings
No Shadings

User's needs
Unlimited load (grid)

System information
PV Array
Nb. of modules
Pnom total

8840
4995

units
kWp

Inverters
Nb. of units
Pnom total
Pnom ratio

16
3999
1.249

units
kWac

### Results summary

Produced Energy | 7041025 kWh/year | Specific production | 1410 kWh/kWp/year Perf. Ratio PR | 85.20 %

### Table of contents

Project and results summary
General parameters, PV Array Characteristics, System losses Main results
Loss diagram
Predef. graphs

2
3
4
5
6

PVsyst V7.4.7
VC0, Simulation date:
28/10/26 12:20
with V7.4.7

### General parameters

Grid-Connected System | No 3D scene defined, no shadings

PV Field Orientation
Orientation
Fixed plane
Tilt/Azimuth | 20 / 0 °

Sheds configuration
No 3D scene defined

Models used
Transposition
Diffuse
Circumsolar

Perez
Perez, Meteonorm
separate

Horizon
Free Horizon

Near Shadings
No Shadings

User's needs
Unlimited load (grid)

### PV Array Characteristics

PV module
Manufacturer
Model

Waaree Energies
BiN-08-565
(Custom parameters definition)
Unit Nom. Power | 565 Wp
Number of PV modules
Nominal (STC)
Modules

8840
4995
340 string x 26

units
kWp
In series
At operating cond. (50°C)
Pmpp
U mpp
I mpp

4620
1034
4467

kWp
V
A

Inverter
Manufacturer
Model

Sungrow
SG250-HX
(Original PVsyst database)
Unit Nom. Power | 250 kWac
Number of inverters Total power | 192 * MPPT 8% 16
| 3999 units
| kWac
Operating voltage Pnom ratio (DC:AC) No power sharing between MPPTs | 500-1450
| 1.25 V

Total PV power
Nominal (STC)
Total
Module area

4995
8840
22836

kWp
modules
m²

Total inverter power
Total power
Number of inverters
Pnom ratio

3999
16
1.25

kWac
units

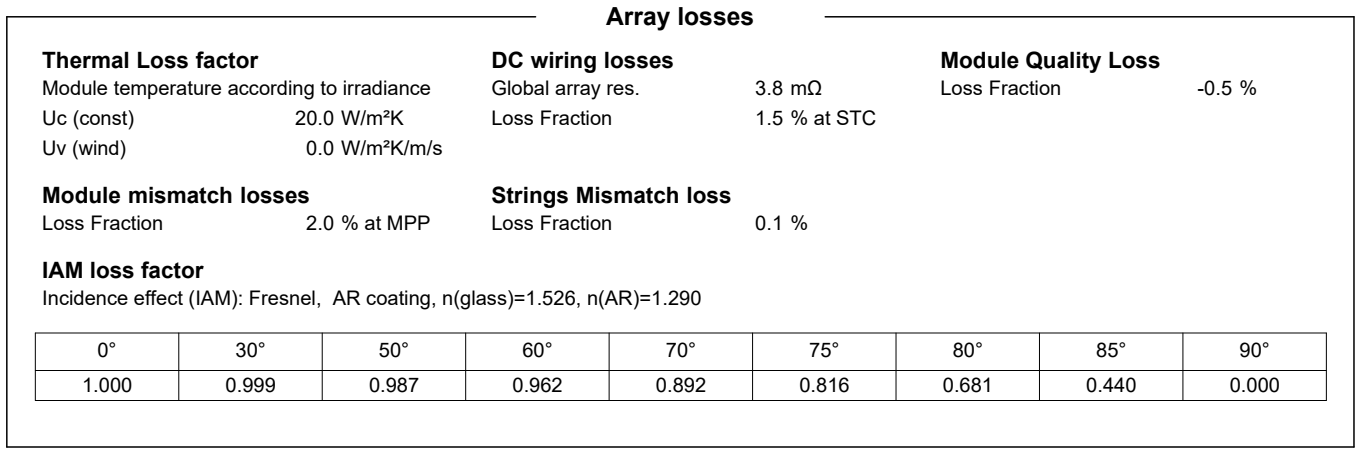
[picture p29: figure]
Array losses; Thermal Loss factor; Module temperature according to irradiance; Uc (const); Uv (wind); W/m²K; W/m²K/m/s; DC wiring losses; Global array res.; Loss Fraction; % at STC; Module Quality Loss; Module mismatch losses; 2.0 % at MPP; Strings Mismatch loss; IAM loss factor

Incidence effect (IAM): Fresnel, AR coating, n(glass)=1.526, n(AR)=1.290

PVsyst V7.4.7
VC0, Simulation date:
28/10/26 12:20
with V7.4.7

### Main results

System Production
Produced Energy | 7041025 kWh/year | Specific production
| | Perf. Ratio PR

1410
85.20

kWh/kWp/year
%
Normalized productions (per installed kWp) | Performance Ratio PR

Balances and main results

| GlobHor kWh/m² | DiffHor kWh/m² | T_Amb °C | GlobInc kWh/m² | GlobEff kWh/m² | EArray kWh | E_Grid kWh | PR ratio
January February March April May June July August September October November December | 112.1 118.0 156.9 166.5 171.7 134.0 128.3 125.0 120.4 121.8 112.8 106.1 | 60.55 67.00 85.04 88.89 96.70 93.63 87.28 83.59 78.22 73.59 60.86 57.07 | 17.45 22.10 27.55 30.18 31.43 30.47 29.78 29.36 28.31 27.25 23.36 18.68 | 135.2 133.7 167.3 167.7 163.5 125.5 120.8 122.5 122.8 132.9 133.4 129.3 | 132.6 131.2 164.0 164.3 159.7 122.2 117.5 119.4 119.8 130.1 130.9 127.0 | 606782 586675 713552 707580 690669 541743 521107 525901 527506 573696 585549 578689 | 597879 577985 703117 696984 679368 531222 510425 515515 518081 564247 576566 569636 | 0.885 0.866 0.841 0.832 0.832 0.847 0.846 0.843 0.845 0.850 0.866 0.882
Year | 1573.6 | 932.42 | 26.34 | 1654.6 | 1618.6 | 7159449 | 7041025 | 0.852

Legends
GlobHor
DiffHor
T_Amb
GlobInc
GlobEff

Global horizontal irradiation Horizontal diffuse irradiation
Ambient Temperature
Global incident in coll. plane
Effective Global, corr. for IAM and shadings

EArray
E_Grid
PR

Effective energy at the output of the array Energy injected into grid
Performance Ratio

### Loss diagram

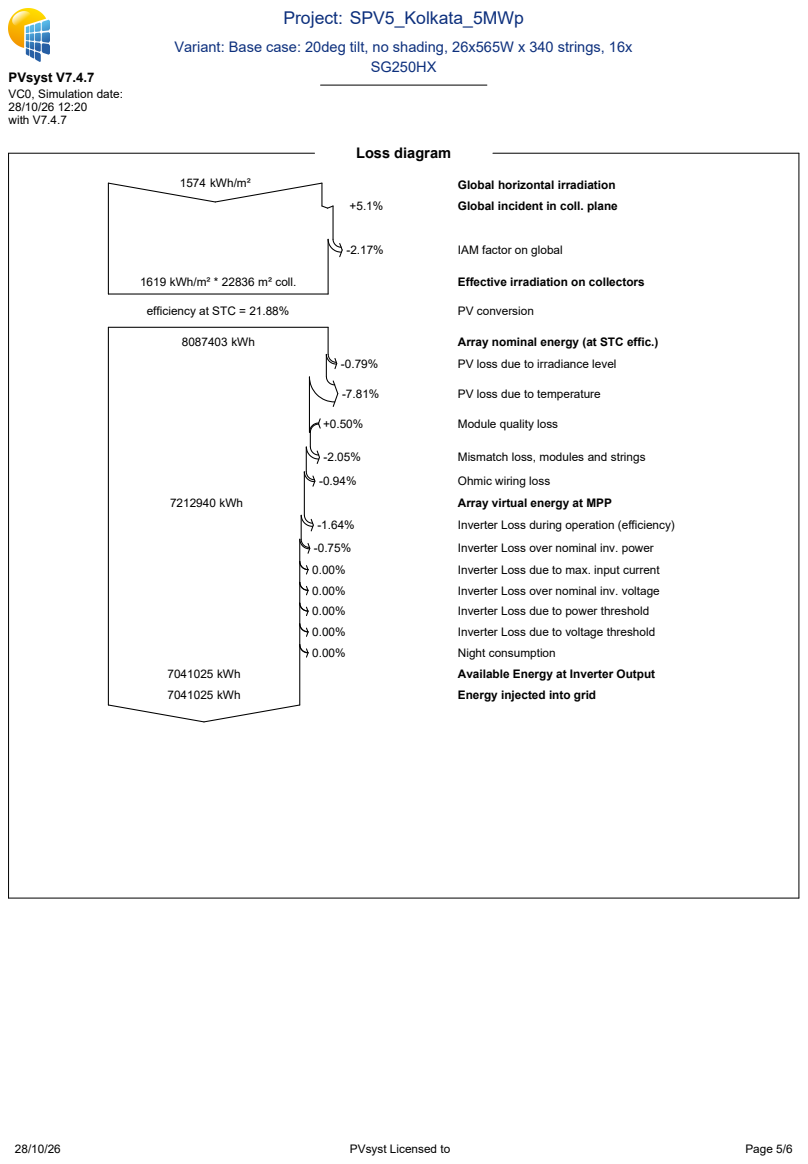
[picture p30: page 5]
PVsyst V7.4.7; VC0, Simulation date: 28/10/26 12:20 with V7.4.7; 1574 kWh/m²; Global horizontal irradiation; Global incident in coll. plane; IAM factor on global; 1619 kWh/m² * 22836 m² coll.; Effective irradiation on collectors; efficiency at STC = 21.88%; PV conversion; 8087403 kWh; Array nominal energy (at STC effic.); PV loss due to irradiance level; PV loss due to temperature; Module quality loss; Mismatch loss, modules and strings; Ohmic wiring loss; 7212940 kWh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

### Predef. graphs

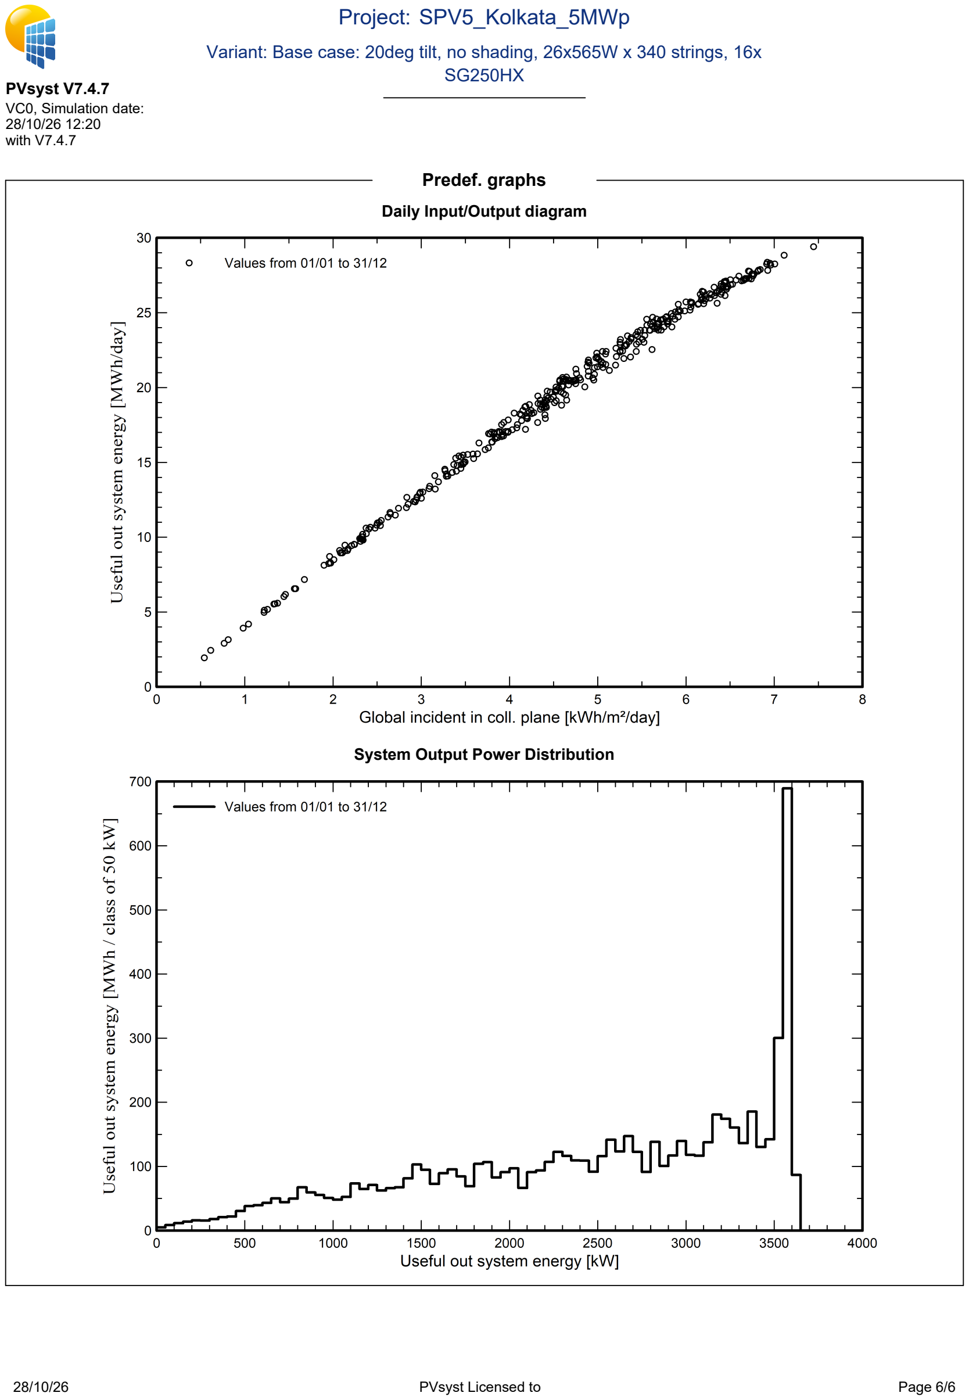
[picture p31: page 6]

PVsyst V7.4.7
VC0, Simulation date:
28/10/26 12:20
with V7.4.7

Daily Input/Output diagram

System Output Power Distribution
