sagnikvolt/solar-pv-plant-5mwp-wb/showcase/images/pvsyst_loss_diagram_VC0_baseline.png

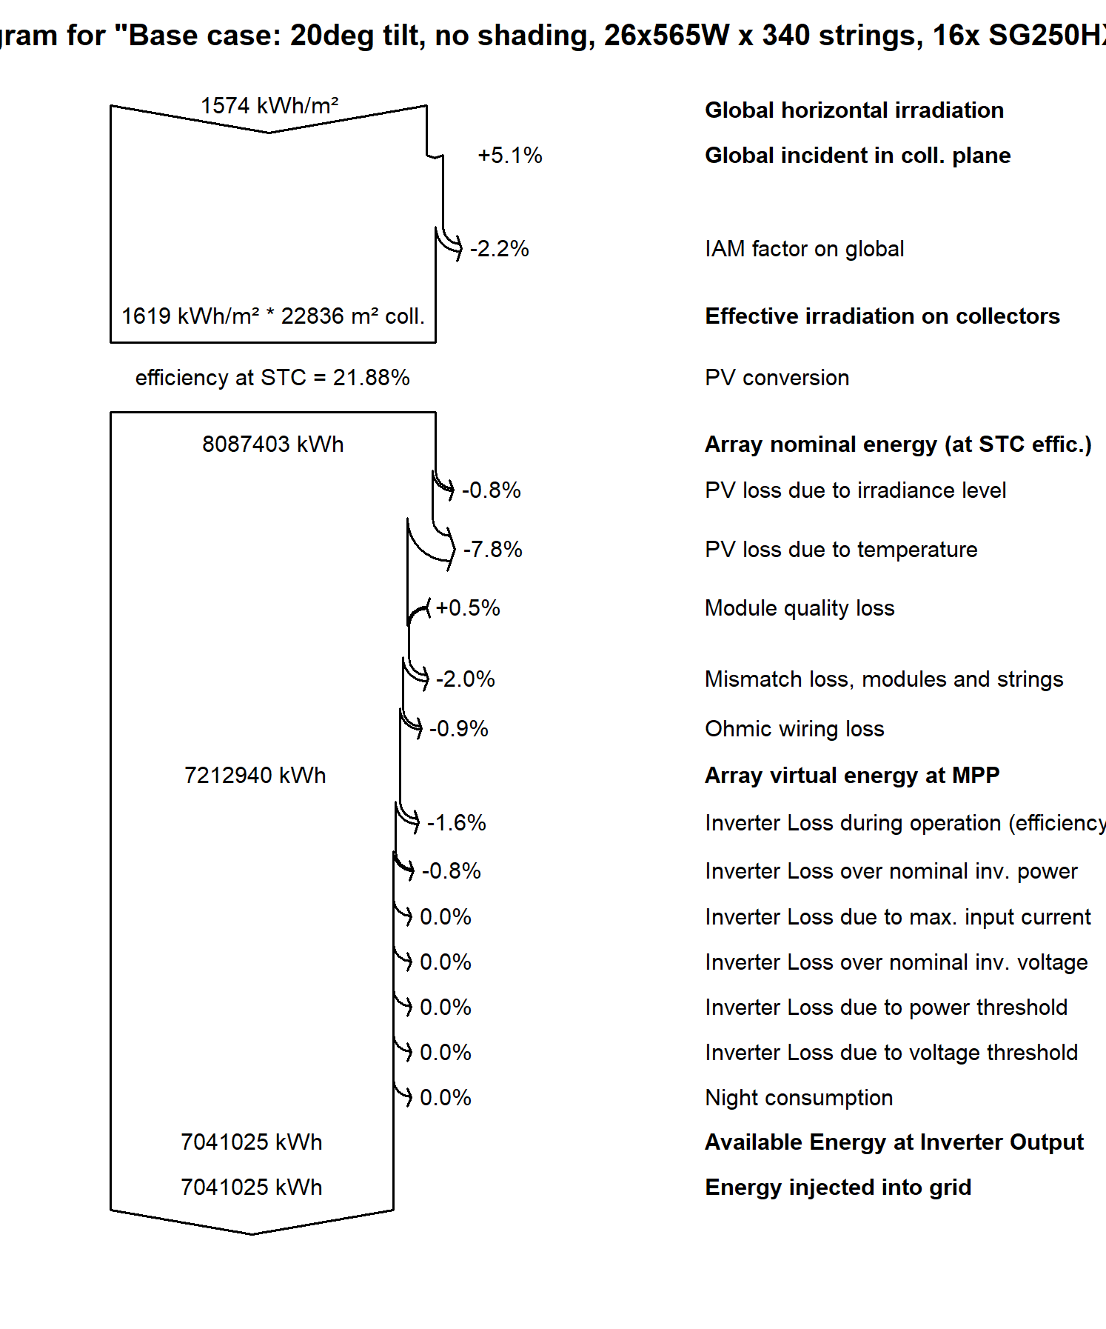
showcase/images/pvsyst_loss_diagram_VC0_baseline.png
