sagnikvolt/solar-pv-plant-5mwp-wb/showcase/images/pvsyst_loss_diagram_VC1_bifacial_shaded.png

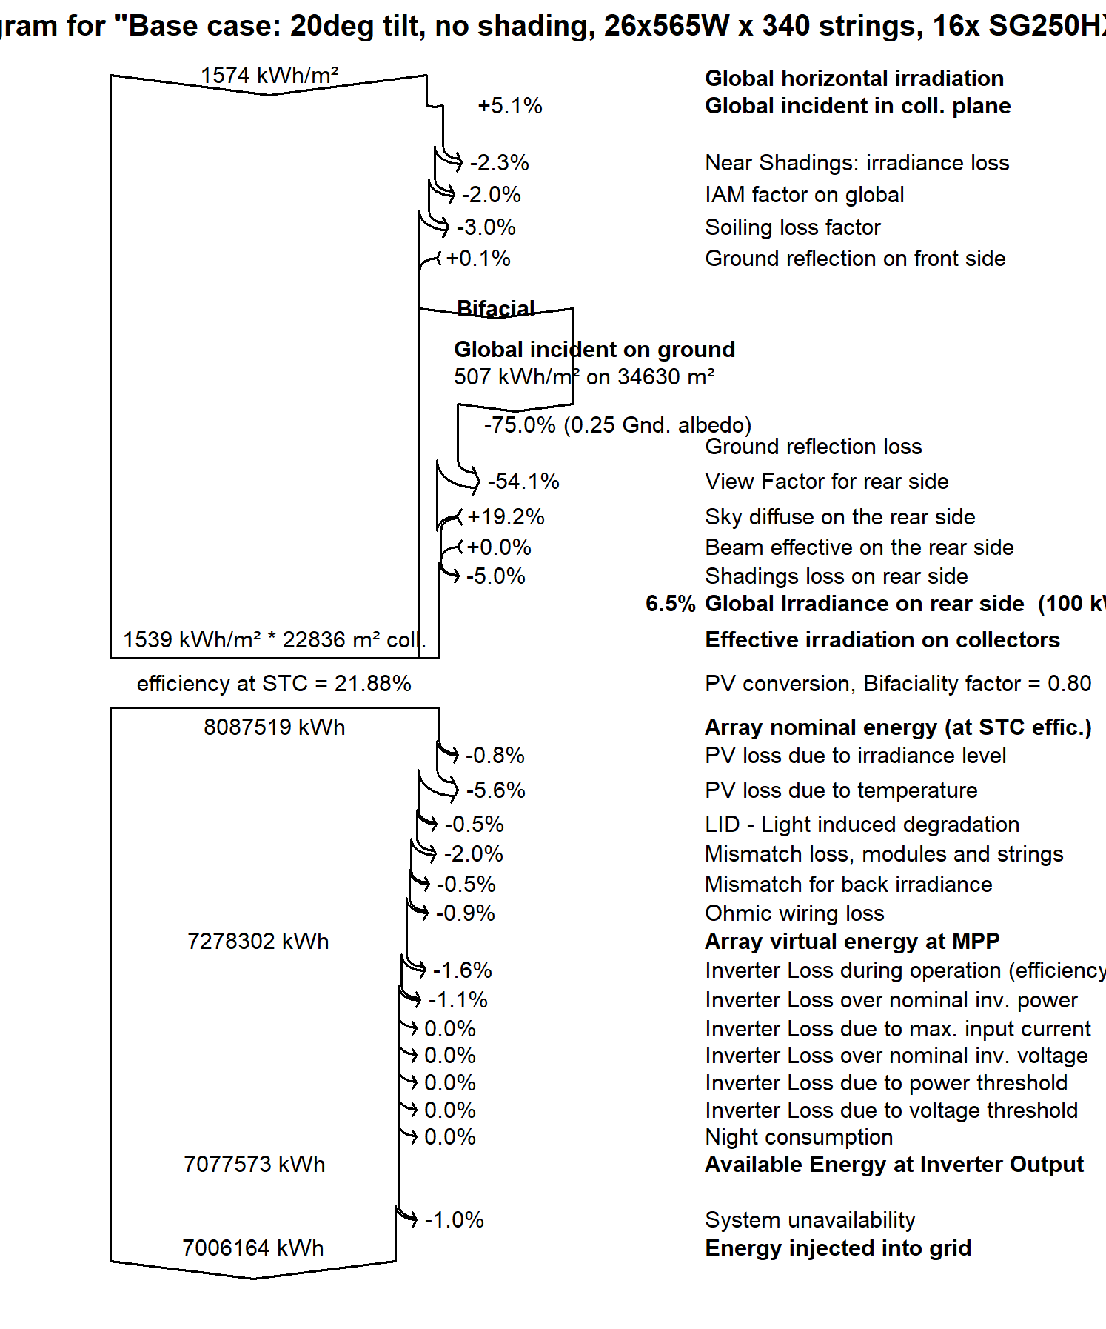
showcase/images/pvsyst_loss_diagram_VC1_bifacial_shaded.png
