sagnikvolt/solar-pv-plant-5mwp-wb/drawings/SPV5-DWG-01-Layout-R0.dxf

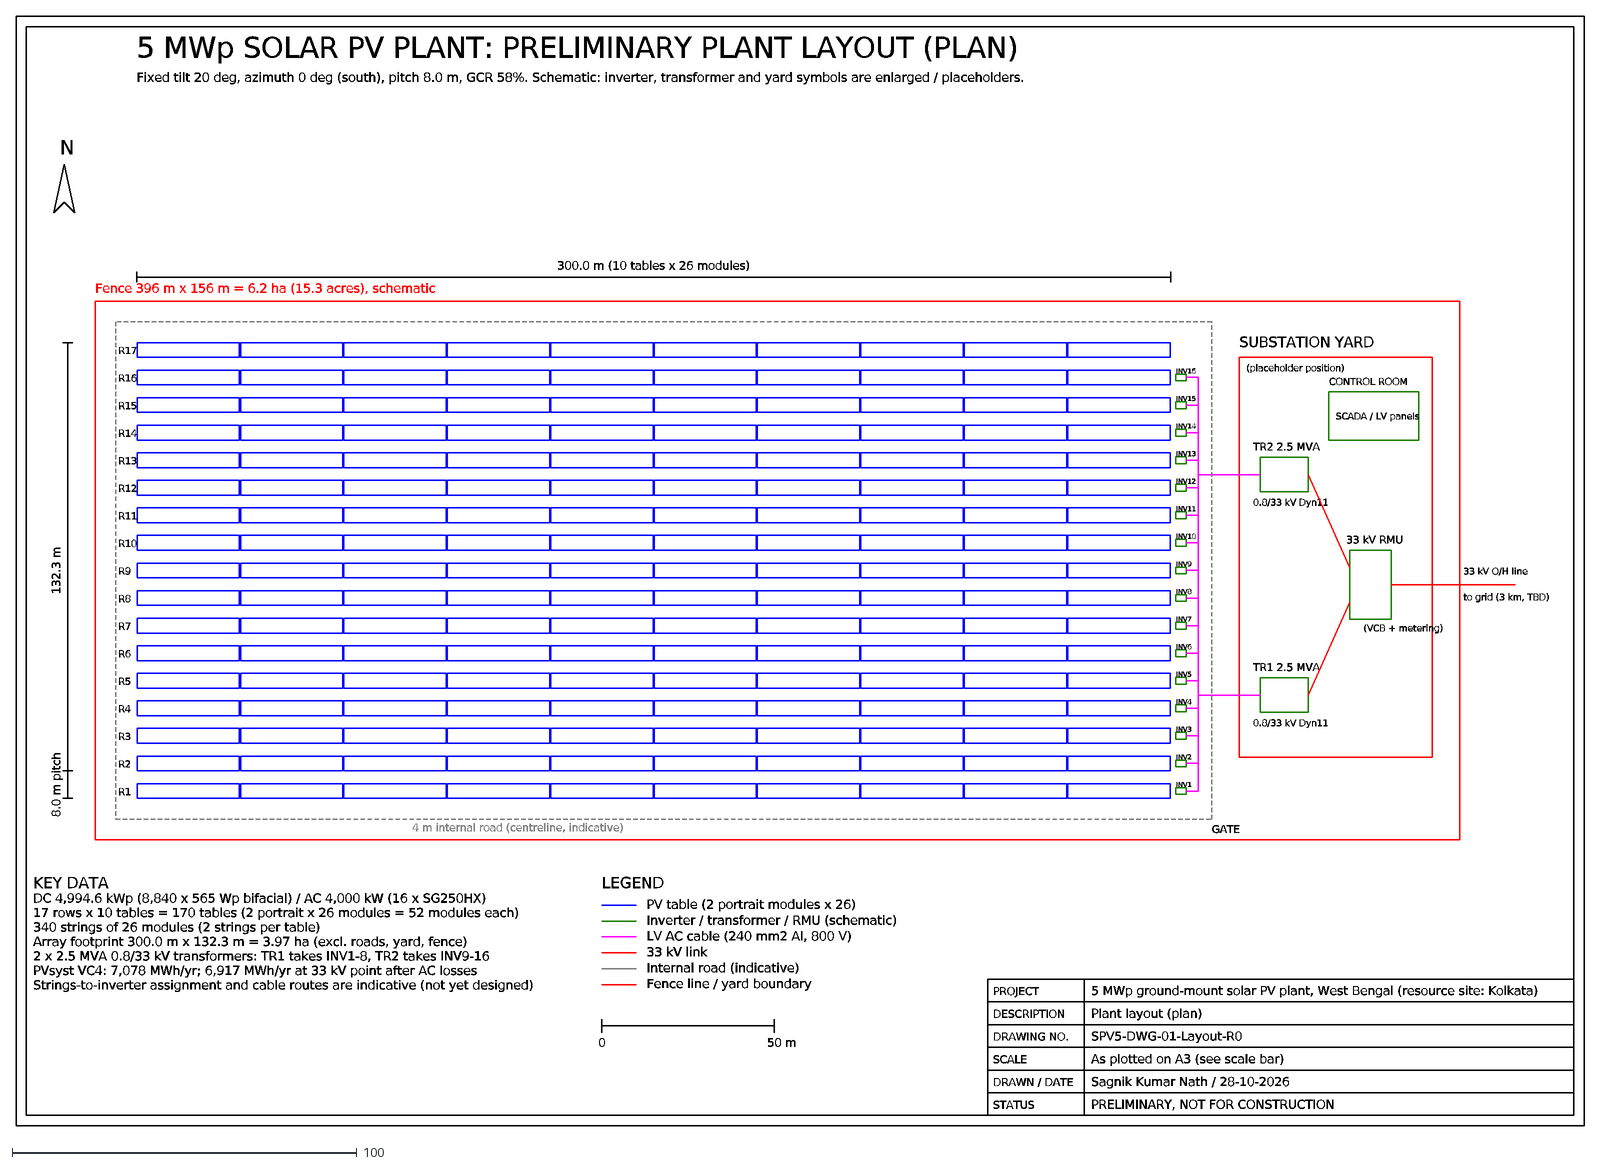
[picture p34: CAD file, 2026-10-28]
drawings/SPV5-DWG-01-Layout-R0.dxf
R1
R2
R3
R4
R5
R6
R7
R8
R9
R10
R11
R12
R13
R14
R15
R16
R17
INV1
INV2
INV3
INV4
INV5
INV6
INV7
INV8
INV9
INV10
INV11
INV12
INV13
INV14
INV15
INV16
SUBSTATION YARD
(placeholder position)
TR1 2.5 MVA
0.8/33 kV Dyn11
TR2 2.5 MVA
33 kV RMU
(VCB + metering)
CONTROL ROOM
SCADA / LV panels
33 kV O/H line
to grid (3 km, TBD)
4 m internal road (centreline, indicative)
GATE
300.0 m (10 tables x 26 modules)
8.0 m pitch
132.3 m
Fence 396 m x 156 m = 6.2 ha (15.3 acres), schematic
N
5 MWp SOLAR PV PLANT: PRELIMINARY PLANT LAYOUT (PLAN)
Fixed tilt 20 deg, azimuth 0 deg (south), pitch 8.0 m, GCR 58%. Schematic: inverter, transformer and yard symbols are enlarged / placeholders.
KEY DATA
DC 4,994.6 kWp (8,840 x 565 Wp bifacial) / AC 4,000 kW (16 x SG250HX)
17 rows x 10 tables = 170 tables (2 portrait x 26 modules = 52 modules each)
340 strings of 26 modules (2 strings per table)
Array footprint 300.0 m x 132.3 m = 3.97 ha (excl. roads, yard, fence)
2 x 2.5 MVA 0.8/33 kV transformers: TR1 takes INV1-8, TR2 takes INV9-16
PVsyst VC4: 7,078 MWh/yr; 6,917 MWh/yr at 33 kV point after AC losses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
