sagnikvolt/solar-pv-plant-5mwp-wb/drawings/SPV5-DWG-02-SLD-R0.dxf

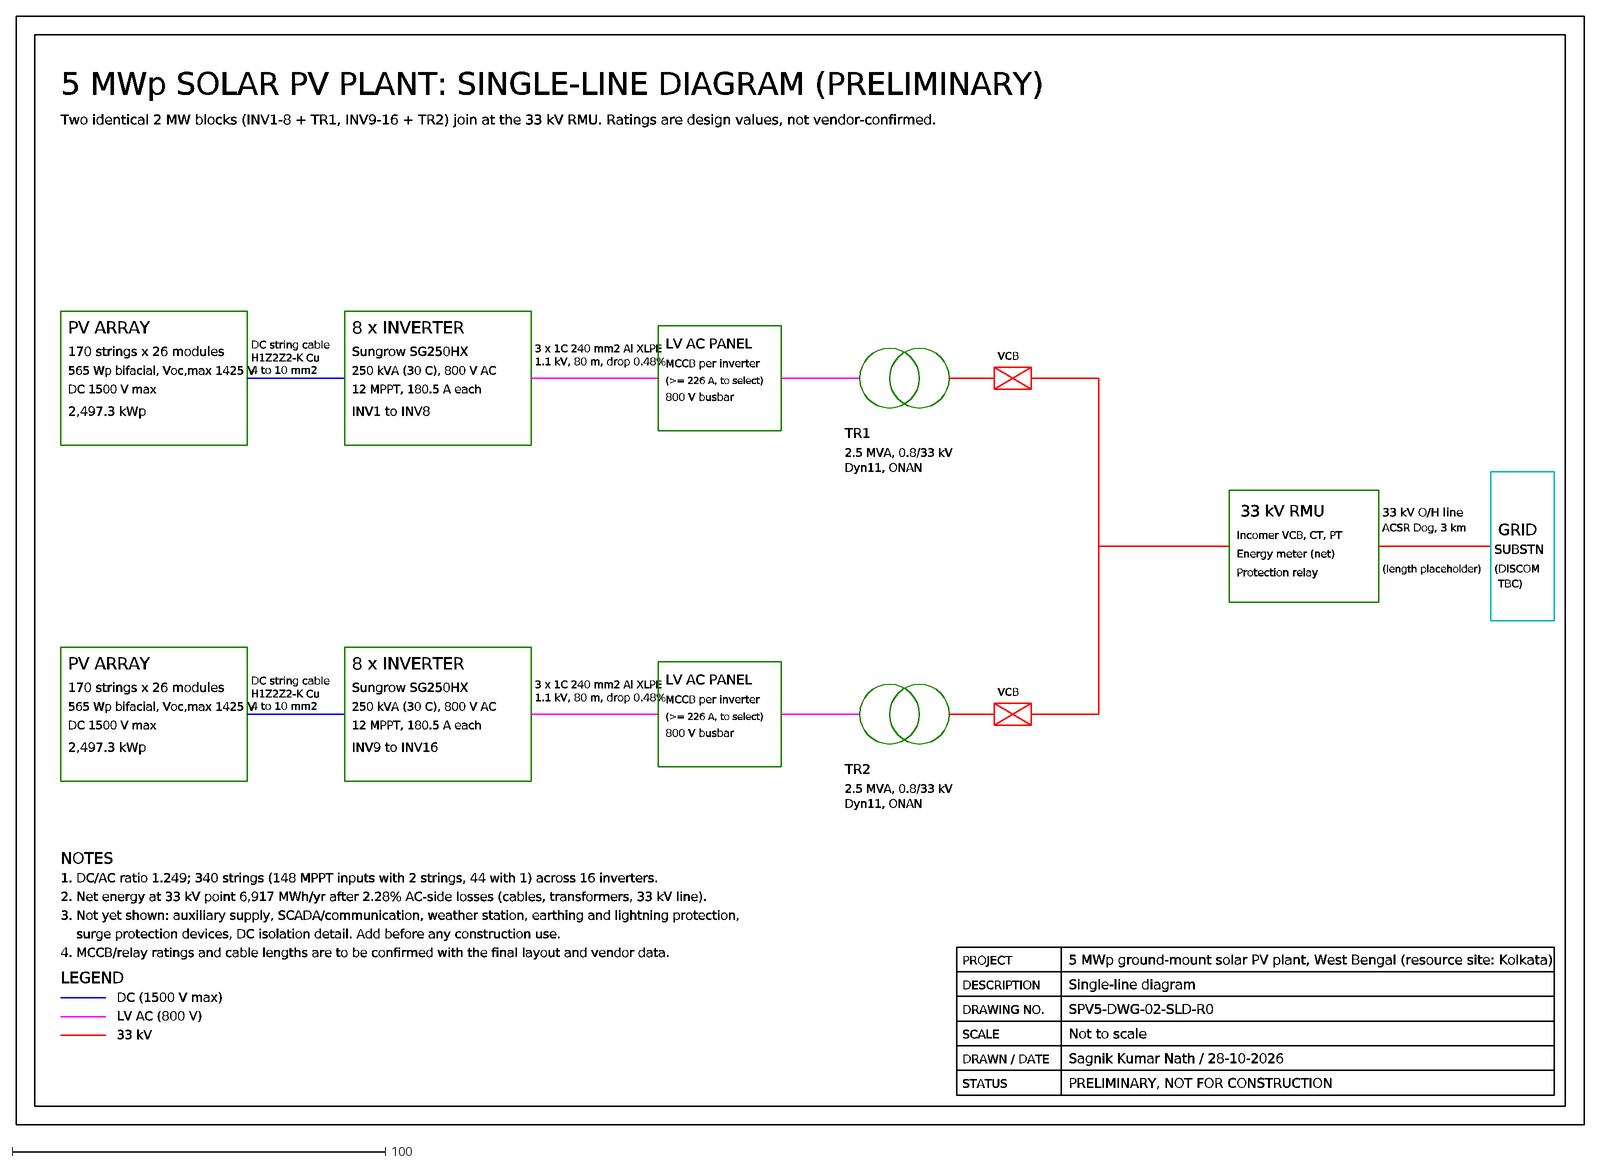
[picture p35: CAD file, 2026-10-28]
drawings/SPV5-DWG-02-SLD-R0.dxf
5 MWp SOLAR PV PLANT: SINGLE-LINE DIAGRAM (PRELIMINARY)
Two identical 2 MW blocks (INV1-8 + TR1, INV9-16 + TR2) join at the 33 kV RMU. Ratings are design values, not vendor-confirmed.
PV ARRAY
170 strings x 26 modules
565 Wp bifacial, Voc,max 1425 V
DC 1500 V max
2,497.3 kWp
DC string cable
H1Z2Z2-K Cu
4 to 10 mm2
8 x INVERTER
Sungrow SG250HX
250 kVA (30 C), 800 V AC
12 MPPT, 180.5 A each
INV1 to INV8
3 x 1C 240 mm2 Al XLPE
1.1 kV, 80 m, drop 0.48%
LV AC PANEL
MCCB per inverter
(>= 226 A, to select)
800 V busbar
TR1
2.5 MVA, 0.8/33 kV
Dyn11, ONAN
VCB
INV9 to INV16
TR2
33 kV RMU
Incomer VCB, CT, PT
Energy meter (net)
Protection relay
33 kV O/H line
ACSR Dog, 3 km
(length placeholder)
GRID
SUBSTN
(DISCOM
TBC)
NOTES
1. DC/AC ratio 1.249; 340 strings (148 MPPT inputs with 2 strings, 44 with 1) across 16 inverters.
2. Net energy at 33 kV point 6,917 MWh/yr after 2.28% AC-side losses (cables, transformers, 33 kV line).
3. Not yet shown: auxiliary supply, SCADA/communication, weather station, earthing and lightning protection,
surge protection devices, DC isolation detail. Add before any construction use.
4. MCCB/relay ratings and cable lengths are to be confirmed with the final layout and vendor data.
LEGEND
DC (1500 V max)
LV AC (800 V)
33 kV
PROJECT
5 MWp ground-mount solar PV plant, West Bengal (resource site: Kolkata)
DESCRIPTION
Single-line diagram
DRAWING NO.
SPV5-DWG-02-SLD-R0
SCALE
Not to scale
DRAWN / DATE
Sagnik Kumar Nath / 28-10-2026
STATUS
PRELIMINARY, NOT FOR CONSTRUCTION
