sagnikvolt/solar-pv-plant-5mwp-wb/(list of files, cad)

Other CAD files:
drawings/SPV5-DWG-01-Layout-R0.dwg
drawings/SPV5-DWG-02-SLD-R0.dwg
