sagnikvolt/solar-pv-plant-5mwp-wb/drawings/SPV5-DWG-01-Layout-R0.pdf

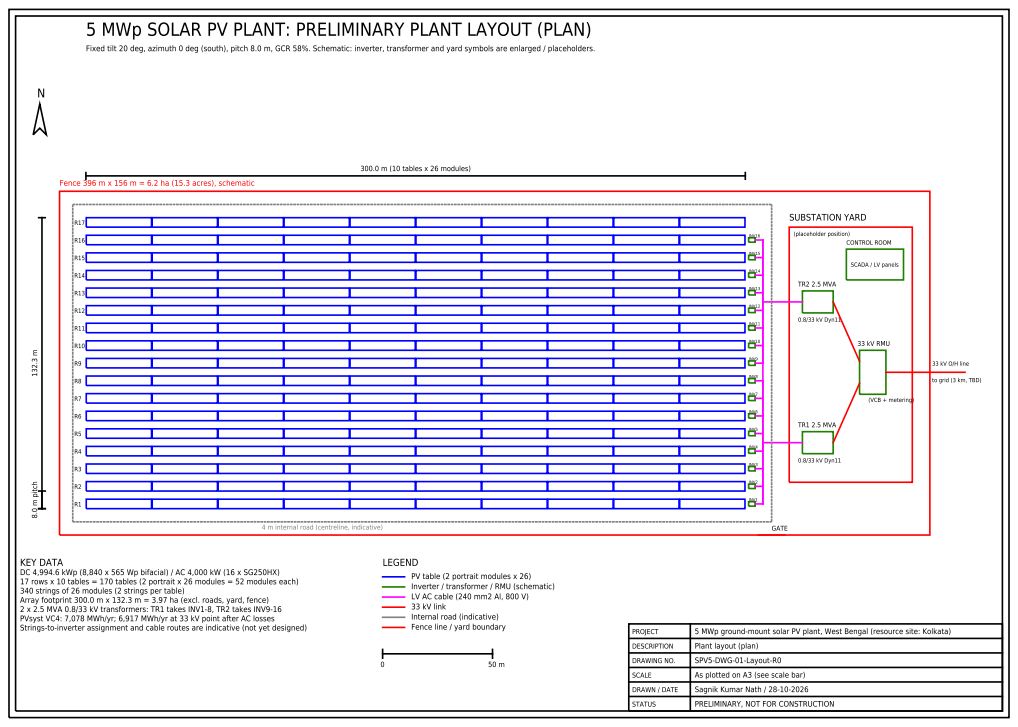
[picture p36: page 1]
