sagnikvolt/solar-pv-plant-5mwp-wb/drawings/SPV5-DWG-02-SLD-R0.pdf

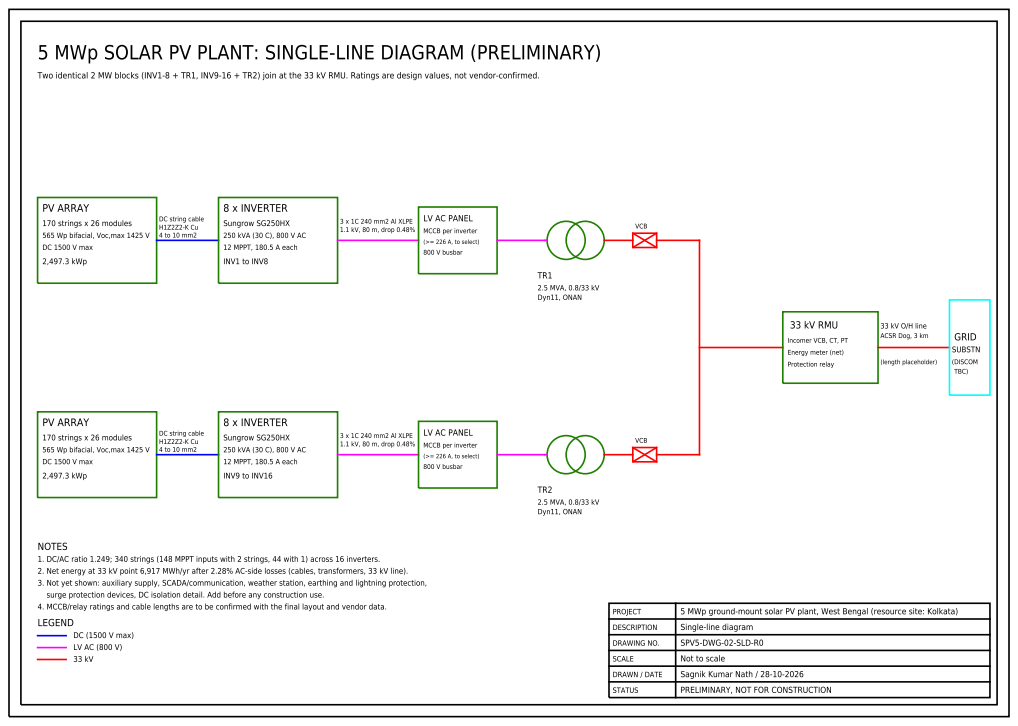
[picture p37: page 1]
