sagnikvolt/solar-pv-plant-5mwp-wb/(commit log)

2026-10-28 Project scaffold: structure, plan, assumption log, string sizing calculator (Python + Excel)
    Claude-Session: https://claude.ai/code/session_01TpFRrSH6xfAGPoJFzVXo4W
    [string_sizing.xlsx, weather_comparison.csv]
2026-10-28 Site: Kolkata. Weather data (PVGIS, NASA POWER), real module/inverter inputs, string sizing passing all checks
    Iteration 1 (580 W, 27 per string) failed the MPPT current check; iteration 2 uses 565 W, 26 per string.
    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
    [string_sizing.xlsx, weather_comparison.csv]
2026-10-28 Meteonorm data, PVsyst project setup notes and baseline results (VC0: 7,041 MWh, PR 0.852)
    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
    [weather_comparison.csv]
2026-10-28 Correct note on Vmp temperature coefficient
    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
2026-10-28 VC1: bifacial model, 3D shed scene, loss review, P50/P90 budget, row pitch calc; docs updated
    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
2026-10-28 Pitch sweep (adopt 8.0 m), monofacial run, SAM/PVGIS cross-check, VC4 report; P50/P90 on VC4
    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
2026-10-28 Add cable sizing and preliminary economics (capex, LCOE, payback, CO2)
    Economics flagged as indicative: cost ranges do not reconcile with auction tariffs.
    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
2026-10-28 Add draft PDF report, interview answers, LinkedIn/CV text; log cable and economics assumptions; update README and PLAN
    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
2026-10-28 Add layout and single-line drawings (DXF/DWG/PDF/PNG), clean loss and monthly charts, 8-page report with drawings; resave PVsyst VC4
    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
    [SPV5-DWG-01-Layout-R0.dwg, SPV5-DWG-01-Layout-R0.dxf, SPV5-DWG-02-SLD-R0.dwg, SPV5-DWG-02-SLD-R0.dxf]
2026-10-28 Correct string-margin wording (3 V applied to the first 580 W iteration, not the final design)
    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
